MasonHuang04/450SourceOri/01_Elec/02_FrontEnd/制板说明.txt

4层板，层方案JLC0416H-3313, 绿油白字喷锡, 不需要过孔塞树脂。

PCB造10片，自己手贴2片。
