MasonHuang04/450SourceOri/01_Elec/01_MainBoard/A0/制板说明.txt

4层板，JLC叠层方案JLC0416H-3313A, 绿油白字喷锡, 过孔塞树脂。

PCB造10片，自己手贴2片。

元器件有好些之前有（电流钳，电流传感器，M之类），好好找找，有的就不要专门卖。FPGA相关的都是M的东西。应该不会有长周期物料。
