MasonHuang04/450SourceOri/verification/MATLAB/McuBudget_20261022/results/report.html

# 当前 FPGA 资源与 STM32G431 预算

2026-10-22。依据与当前SOF逐字节哈希匹配的Quartus报告，保留19 ms RX、1.145833 MS/s、CIC3 /32、672/1024 FFT及25–2000 Hz搜索。

判断：1024点FFT本身不是否定G431的理由。采用DMA分块、流式混频/CIC、结果为主的方案有实现可能；不能把现有256 KiB波形缓存原样搬进32 KiB SRAM。若保留全部波形、物理正弦参考DAC和更多缓冲，RAM很紧。采集实时性仍须用真实MCU代码测量，本文没有用MATLAB耗时冒充MCU耗时。

## 1. 实际 FPGA 资源

当前含TMP117温度补偿和M4距离报文：8507 ALM、17561寄存器、44 DSP、272 M10K，配置存储位数2201010 bits，约268.68 KiB。之前仅25–2000 Hz FFT版为7053 ALM、31 DSP，存储相同。

output_files中的详细fit.rpt仍是旧版，但fit.summary/build_checks与当前SOF一致。本次从验证资料引用的编译快照找到匹配当前SOF的完整fit.rpt，按其实体表统计；没有改写旧报告。

模块 | ALM（层级估算） | DSP块 | 配置存储 KiB | M10K
MainTxController | 3234.0 | 19 | 7.244 | 10
MainRxController | 910.4 | 3 | 0.000 | 0
MainFftProcessor | 1908.8 | 8 | 5.434 | 6
kaiser4_rfft | 763.3 | 5 | 3.434 | 4
fft_power_peak | 113.0 | 2 | 0.000 | 0
main_peak_interpolator | 537.5 | 1 | 0.000 | 0
MainRangeCalculator | 1440.9 | 13 | 0.000 | 0
MainWaveFifo | 275.0 | 0 | 256.000 | 256

FFT分支包括下属CIC、加窗FFT、功率和插值，父子行不能相加。原始波形缓存配置为131072×16位，即256 KiB，占全工程配置存储位数的95.28%。M10K块数还包含物理分块碎片，不能把块数直接当有效数据字节数。

44个FPGA DSP块不等于MCU需要44个处理器。FPGA硬件并行且有些模块只在每帧运行一次，MCU可复用乘法/FPU。TX部分目前在165 MHz DAC时钟流水计算浮点Chirp，不能直接逐拍移植到170 MHz CPU；方波版本应让定时器/PWM/DMA承担边沿输出。

## 2. 每帧算法工作量

19 ms约21770个原始样本/通道。原FPGA使用外部模拟混频，MCU数字混频方案新增一次RX×参考乘法/样本。下表是公式运算次数，不是CPU周期，未把搬运、寻址、缩放、饱和、循环、外设与中断开销算成免费。

阶段 | 乘法表达式/帧 | 加减/帧 | 说明
Digital RX x reference mixing (new) | 21770 | 0 | Rescaling/saturation/memory access excluded
CIC3 integrators | 0 | 65310 | 40-bit FPGA states: typically 64-bit MCU arithmetic
CIC3 combs | 0 | 2040 | One decimated output per 32 raw samples
Frame sum and DC removal | 0 | 1344 | One mean division per frame
Kaiser4 window | 672 | 0 | Precomputed coefficients, no runtime Bessel evaluation
1024 real FFT: 512 complex FFT + split | 10236 | 16376 | Expression counts, not optimized CMSIS instructions
Power at all 513 bins | 1026 | 513 | Only 59 bins are needed for equivalent peak/neighbour processing
Peak comparison in bins 1 to 57 | 0 | 0 | 57 eligible bins, approximately 56 max comparisons
Peak interpolation | 0 | 0 | 3 logarithms and 1 divide, or existing 48-squaring fixed algorithm

1024实数FFT按当前实现分解为512复数FFT的2304个蝶形，加上实数频谱重组。运算表达式约10236次实乘和16376次加减；CMSIS使用不同的优化内核，实际指令数不一定等于这个计数。三点插值每帧只有3次log和1次除法；温度与距离同样每帧计算一次，通常不是持续采集的主负载。

现有FPGA的数字FFT处理实测为23430个50 MHz周期，约0.4686 ms；插值140周期约2.8 us，新增距离计算最多168周期约3.36 us。FPGA并行资源与CPU指令不同，不能按170/50简单换算为MCU耗时。

## 3. 采集期间的硬预算

170 MHz / 1.145833 MS/s = 148.36 CPU周期/样本对，即每0.873 us来一对同步样本。采用512对样本的DMA半缓冲时，处理期限约446.84 us，共约75962周期。应按最坏执行时间验收，并留中断、PWM与通信余量；以不超过约74周期/样本对作为50%预算目标，而非已测性能。

假设完整流式处理成本 | 采集期间CPU占用 | 19 ms内CPU工作时间
32 | 21.6% | 4.098 ms
64 | 43.1% | 8.196 ms
96 | 64.7% | 12.294 ms
128 | 86.3% | 16.392 ms
160 | 107.8% | 20.489 ms

这些周期值是敏感性情景，不是G431测量。完整流式成本须包括RX乘参考、40位CIC所需的64位运算、定标、存取和循环。若数字参考也由CPU生成，需把相位更新/查表成本一起算入。应使用预计算表或经验证的相位递推，避免每个原始样本调用通用double sin/cos。

若坚持输出模拟正弦参考再双ADC采样，参考DAC生成也是额外工作。举例：ADC混频/CIC若需64周期/样本，另以1 MS/s、32周期/样本生成DAC参考，合计约62% CPU；如果ADC处理128周期且DAC生成40周期，则超过170 MHz预算。这仍是假设情景。片内外部DAC最高1 MS/s，不能复现原FPGA的165 MS/s DAC更新节拍。

## 4. FFT耗时的证据边界

ST AN4841的另一款Cortex-M4（STM32F429）1024点复数FFT基准给出Q15为82299周期、Q31为153307周期。仅假设相同周期数，在170 MHz分别约0.484 ms、0.902 ms。它们不是G431的实数float32 FFT实测。可先给FFT预留0.5–1.5 ms工程预算，最终用选定CMSIS版本、数据类型、编译选项和内存布局测量。

CMSIS的float32快速RFFT利用实数对称性，1024点输入与输出各1024个float，合计8 KiB。Q15/Q31的输出布局和容量可能不同，不应直接套用8 KiB估算。CMSIS输出缩放也必须与当前功率门限和插值对照验证。

## 5. 32 KiB SRAM怎样安排

分配项 | 字节 | KiB
RFFT input/work buffer | 4096 | 4.000
RFFT output buffer | 4096 | 4.000
Dual ADC DMA, 2 halves x 512 pairs | 4096 | 4.000
Filter state, telemetry and scratch reserve | 1024 | 1.000
Application/HAL/stack reserve | 4096 | 4.000
Optional runtime PWM ARR/CCR table | 3200 | 3.125
Optional current RX waveform buffer | 10884 | 10.629
Optional sine-reference DAC ping-pong buffer | 2048 | 2.000

结果为主的基础方案约17.000 KiB；加运行时PWM表约20.125 KiB。保留当前5442点波形后约30.754 KiB，余量仅1.246 KiB；再加模拟参考DAC双缓冲约32.754 KiB，已超过32 KiB。预先固定的PWM表若可放Flash，可以减少RAM，但运行时改TX参数的需求也要考虑。这里的1 KiB scratch与4 KiB应用/栈是设计预留，不是链接器实测。

整帧原始ADC一路需要42.52 KiB、两路需要85.04 KiB，均不能直接存入32 KiB。窗系数、旋转因子、相位表应优先放Flash，并只链接需要的FFT尺寸。若产品要保存两路完整原始波形，至少重新评估128 KiB级或更大RAM器件，而不是只比较CPU频率。

## 6. 其他必须保留在预算里的约束

当前完整原始波形+M4为11058字节，2 Mbaud/8N1线路时间约55.29 ms；只发110字节M4约0.55 ms。若还保持每帧完整波形回传，串口可能先于FFT成为刷新率限制。当前上位机连续模式还有约1秒等待，低平均CPU负载不能代替采集窗口内的实时性检查。

G431原生ADC为12位，当前模型是16位，性能不能仅凭采样率等同。ADC取样时间、DMA可达地址、准确采样率、双通道偏斜、参考相位同步、定时器周期量化和模拟前端都需另外验证。本预算保持现有CIC，没有计入将来可能增加的FIR/IIR抗混叠或声学补偿计算。

## 建议的MCU验收

1. 先用DMA分块实现采样、数字混频和CIC。测DWT_CYCCNT的最坏周期数及DMA溢出计数，保持ADC流无丢点。
2. 离线对比672点输出、1024点FFT及峰值插值，再测整帧计算时间，不能只测单独FFT。
3. 查看真实链接器RAM/Flash占用与栈高水位，同时运行PWM、ADC、温度和UART。决定是否保留整帧波形。

来源：ST G431数据手册 (https://www.st.com/resource/en/datasheet/stm32g431rb.pdf)；ST AN4841 (https://www.st.com/content/ccc/resource/technical/document/application_note/group0/c1/ee/18/7a/f9/45/45/3b/DM00273990/files/DM00273990.pdf/jcr:content/transla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)；Arm CMSIS-DSP RFFT文档 (https://arm-software.github.io/CMSIS-DSP/main/group__RealFFT.html)。FPGA数据的SOF哈希与来源路径见fpga_resources.json。

运算量CSV · CPU预算CSV · RAM预算CSV · FPGA模块占用 · 预算参数
