MasonHuang04/450SourceOri/verification/FFT/full_top/spectrum.csv

case | bin | real | imag | power
0 | 0 | -9 | 0 | 81
0 | 1 | 11 | 2 | 125
0 | 2 | 6 | 3 | 45
0 | 3 | 5 | 5 | 50
0 | 4 | 5 | 7 | 74
0 | 5 | 5 | 9 | 106
0 | 6 | 5 | 11 | 146
0 | 7 | 5 | 13 | 194
0 | 8 | 5 | 16 | 281
0 | 9 | 5 | 19 | 386
0 | 10 | 6 | 22 | 520
0 | 11 | 6 | 27 | 765
0 | 12 | 6 | 32 | 1060
0 | 13 | 6 | 38 | 1480
0 | 14 | 7 | 46 | 2165
0 | 15 | 7 | 56 | 3185
0 | 16 | 9 | 71 | 5122
0 | 17 | 10 | 91 | 8381
0 | 18 | 12 | 123 | 15273
0 | 19 | 16 | 178 | 31940
0 | 20 | 23 | 286 | 82325
0 | 21 | 39 | 520 | 271921
0 | 22 | 530 | 7694 | 59478536
0 | 23 | -1111 | -16623 | 277558450
0 | 24 | 279 | 4226 | 17936917
0 | 25 | 26 | 370 | 137576
0 | 26 | 10 | 118 | 14024
0 | 27 | 5 | 43 | 1874
0 | 28 | 3 | 13 | 178
0 | 29 | 2 | -2 | 8
0 | 30 | 2 | -9 | 85
0 | 31 | 2 | -13 | 173
0 | 32 | 2 | -15 | 229
0 | 33 | 1 | -16 | 257
0 | 34 | 1 | -17 | 290
0 | 35 | 1 | -17 | 290
0 | 36 | 1 | -17 | 290
0 | 37 | 2 | -17 | 293
0 | 38 | 1 | -17 | 290
0 | 39 | 2 | -16 | 260
0 | 40 | 1 | -16 | 257
0 | 41 | 1 | -16 | 257
0 | 42 | 2 | -15 | 229
0 | 43 | 1 | -15 | 226
0 | 44 | 1 | -14 | 197
0 | 45 | 1 | -15 | 226
0 | 46 | 1 | -14 | 197
0 | 47 | 1 | -14 | 197
0 | 48 | 2 | -13 | 173
0 | 49 | 2 | -13 | 173
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
