MasonHuang04/450SourceOri/verification/FFT/Main_20261017/spectrum_100hz.csv

bin | frequency_hz | real_q3 | imag_q3 | power_q6
0 | 0 | 6 | 0 | 36
1 | 4.37100728353 | 1 | 1 | 2
2 | 8.74201456706 | 2 | 3 | 13
3 | 13.1130218506 | 2 | 5 | 29
4 | 17.4840291341 | 2 | 7 | 53
5 | 21.8550364176 | 1 | 9 | 82
6 | 26.2260437012 | 1 | 11 | 122
7 | 30.5970509847 | 2 | 13 | 173
8 | 34.9680582682 | 2 | 16 | 260
9 | 39.3390655518 | 2 | 19 | 365
10 | 43.7100728353 | 1 | 23 | 530
11 | 48.0810801188 | 1 | 27 | 730
12 | 52.4520874023 | 1 | 32 | 1025
13 | 56.8230946859 | 2 | 38 | 1448
14 | 61.1941019694 | 1 | 46 | 2117
15 | 65.5651092529 | 1 | 56 | 3137
16 | 69.9361165365 | 1 | 71 | 5042
17 | 74.30712382 | 0 | 91 | 8281
18 | 78.6781311035 | 0 | 124 | 15376
19 | 83.049138387 | -1 | 179 | 32042
20 | 87.4201456706 | -2 | 287 | 82373
21 | 91.7911529541 | -6 | 523 | 273565
22 | 96.1621602376 | -99 | 7714 | 59515597
23 | 100.533167521 | 226 | -16674 | 278073352
24 | 104.904174805 | -57 | 4234 | 17930005
25 | 109.275182088 | -4 | 370 | 136916
26 | 113.646189372 | 0 | 118 | 13924
27 | 118.017196655 | 1 | 43 | 1850
28 | 122.388203939 | 1 | 13 | 170
29 | 126.759211222 | 2 | -2 | 8
30 | 131.130218506 | 1 | -9 | 82
31 | 135.501225789 | 2 | -13 | 173
32 | 139.872233073 | 2 | -15 | 229
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
