MasonHuang04/450SourceOri/verification/FFT/Interpolation_20261020/report.html

# Main：FPGA 内的三点峰值插值

2026-10-20 · 本地实现与验证 · 新 Main SOF + M2 上位机

采样 → CIC /32 → Kaiser4 → 8192 点 FFT → 最大功率频点 → 三点对数插值（新增） → UART

插值发生在 FFT 之后，利用峰值及左右邻点估计峰顶位置。log、除法和偏移均在 FPGA 完成；电脑只解析 Q16 结果并换算 Hz。Chirp、RX 250 ms、采样率、8192点和两个独立实验保持原样。

验证通过：完整 Main 数字处理分支、1136组插值检查、71614点原始数据/M2回传、短ADC与真实2 Mbaud UART、生产C#解析。Quartus全编译通过；84项时序检查无负余量，最小 +0.008 ns，无未约束的Setup/Hold路径。

## 完整 Main RTL 的前后对比

输入 Hz | 原频点 Hz | 插值 Hz | 原误差 Hz | 插值误差 Hz
25 | 26.226044 | 24.861304 | +1.226044 | -0.138696
100 | 100.533168 | 99.921029 | +0.533168 | -0.078971
500 | 498.294830 | 500.113038 | -1.705170 | +0.113038
250 | 249.147415 | 250.115245 | -0.852585 | +0.115245
99.6 | 100.533168 | 99.477566 | +0.933168 | -0.122434

250 Hz案例叠加700 Hz干扰；99.6 Hz案例叠加抽取后的混叠频率附近干扰。异常削顶、短帧、空帧都不会被当作有效插值。功率仍报告原最大频点的功率。

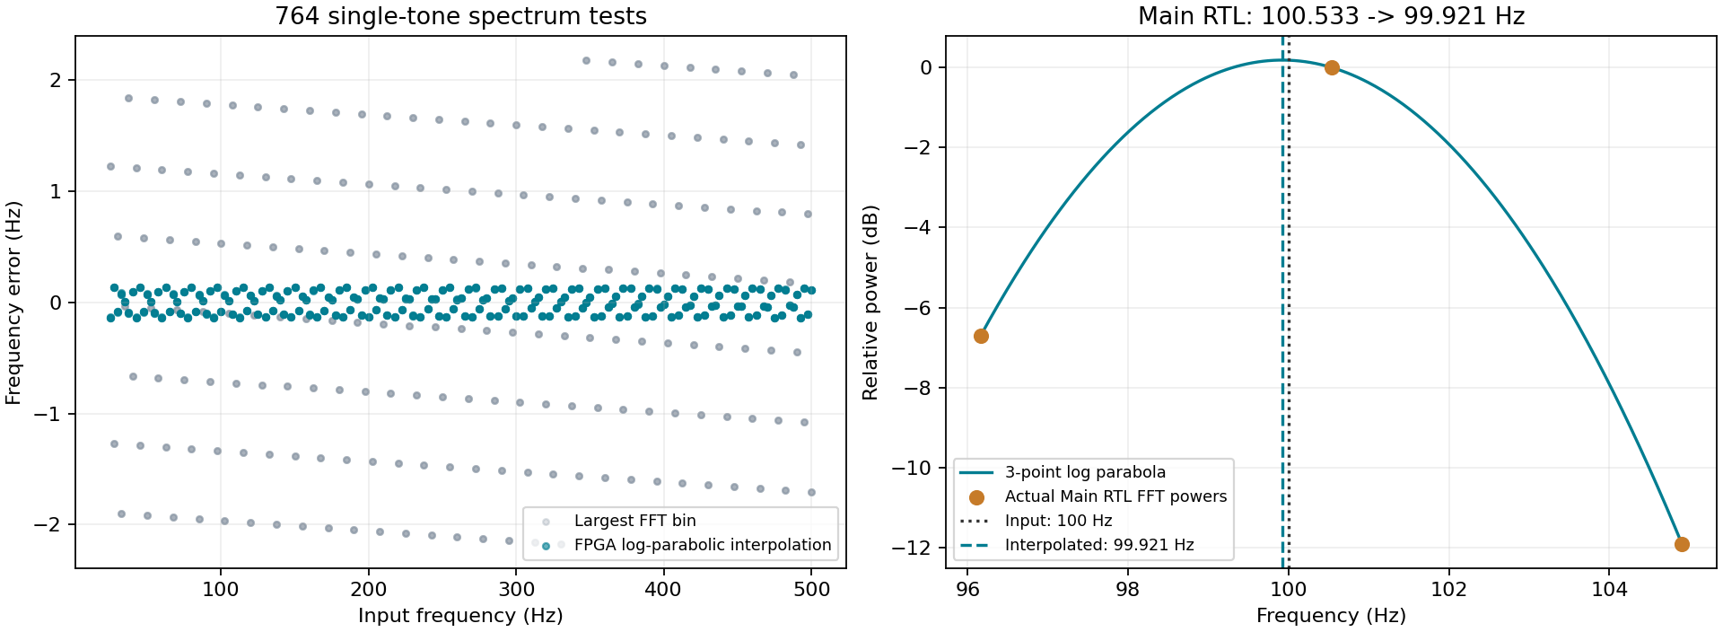
[picture p12: verification/FFT/Interpolation_20261020/comparison.png]


左图：NumPy生成量化频谱，实际RTL完成插值（191频率×4相位）；右图：完整Main RTL产生的100 Hz频谱。左图最大绝对误差从2.1806 Hz降至0.1404 Hz；另60组25 dB单音输入最大插值误差约0.1479 Hz。测试条件不同于论文图中的毫米测距指标。

## 运算量与资源

频率格仍为4.371007 Hz。新增插值最大140个50 MHz周期，约2.8 μs；不是减少现有FFT运算。资源为7190 ALM（13%）、31 DSP（20%）、307 RAM块（45%）；相比旧Main多584 ALM、874寄存器和1 DSP，块RAM用量不变。

## 使用方法

1. 在Programmer重新下载 Main 的 UsMimoTestBench.sof。
2. 运行 03_SW/RunMain.cmd，选主板COM口。
3. 外部发生器向RX输入连续100 Hz正弦，使用此前已验证的幅度与接线；点击“应用并采集一次”。
4. 比较界面的“FPGA插值”“原频点”和误差；参考频率只用于评价，不参与估计。

新软件兼容旧M1；旧固件会标明“未提供插值”。新固件使用76字节M2，需配套新版查看器。尚未进行这版固件的实板验证。

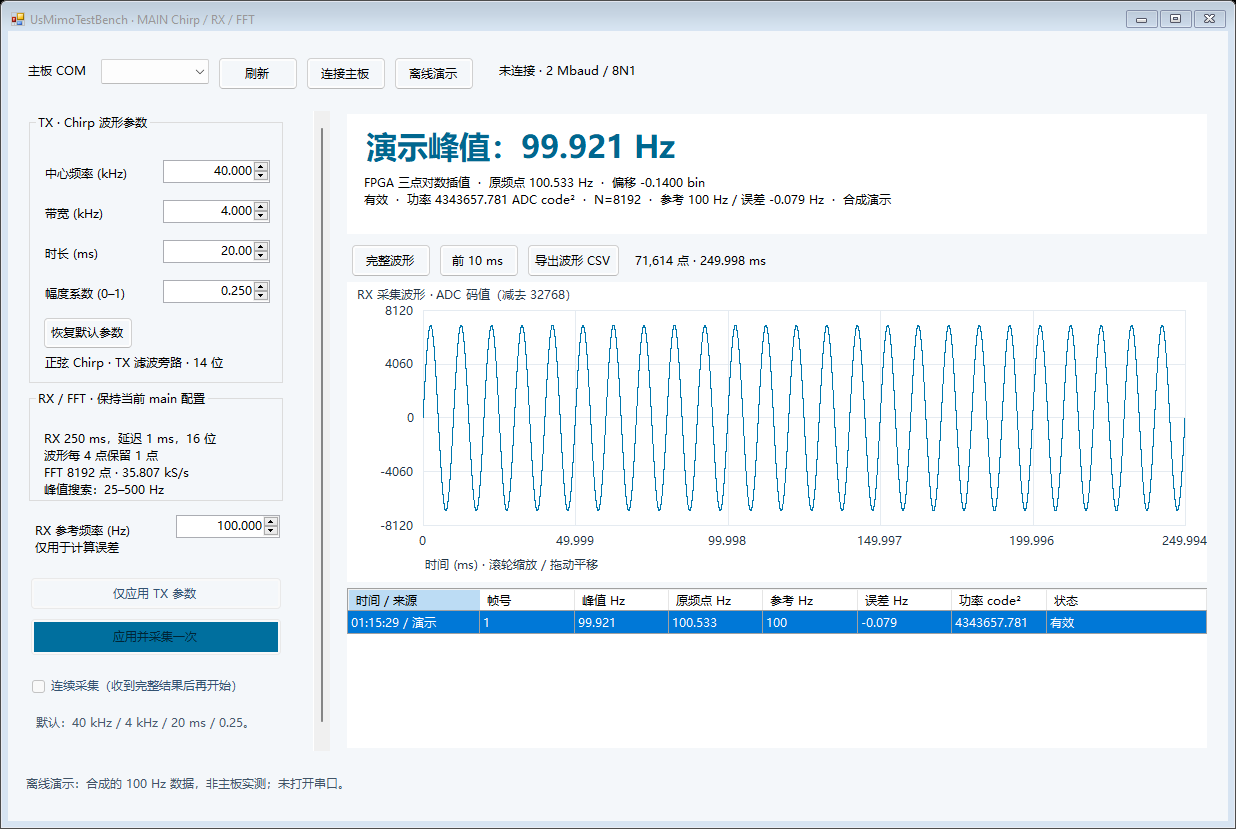
[picture p13: verification/FFT/Interpolation_20261020/ui.png]


界面截图为离线合成演示，不是实板测量。

## 可复现入口

在Simulation/FFT中运行 python run_main.py --interp、--fast-memory、--system、--short 或 --io。沿用原来的两个FFT测试台文件。

检查数据 · 对比CSV · 源码/日志证据 · 算法、协议与使用说明

插值提升孤立峰的位置估计，不改变采集时长或物理分辨能力；不能保证噪声、多目标、非稳态或实板条件下都达到上述误差。没有新增FPGA混频或距离换算。
