MasonHuang04/450SourceOri/(list of files, cad)

Other CAD files:
02_RTL/V0/AD.stp
