MasonHuang04/450SourceOri/verification/Figures/README.md

# 汇报素材

- [早期200kHz TX扫频图](200k_summary/01_TX_sweep.png)
- [早期RX对齐示意图](200k_summary/02_RX_aligned.png)
- [FFT参考输入图](fft_reference_input/FFT_Input_725p587Hz.png)
- [FFT参考输入原始数据](fft_reference_input/FFT_Input_725p587Hz.csv)

这些是此前汇报的素材，保留原有含义，不代表当前40kHz发射/50–100Hz FFT配置。当前示例图见Simulation的两个results目录。draw.io中原始数据链接已随目录调整。
