MasonHuang04/450SourceOri/verification/FFT/full_top/metadata.csv

case | count | span | flags | bin | power | dc_mean
0 | 2048 | 6288384 | 0 | 23 | 277558450 | 114
