MasonHuang04/450SourceOri/verification/AcousticAudit_20261020/data/rtl_metadata.csv

case | seq | count | span | flags | bin | power | mean | delta_q16 | interp_status | process_cycles
0 | 1 | 672 | 21472 | 0 | 2 | 112232500 | -4820 | -24901 | 0 | 23430
1 | 2 | 672 | 21472 | 0 | 2 | 104559496 | 6826 | 30416 | 0 | 23430
2 | 3 | 672 | 21472 | 0 | 4 | 121257009 | -4961 | 12053 | 0 | 23430
3 | 4 | 672 | 21472 | 0 | 3 | 123445274 | 299 | -9562 | 0 | 23430
4 | 5 | 672 | 21472 | 0 | 11 | 121297114 | 304 | -9120 | 0 | 23430
5 | 6 | 672 | 21472 | 36 | 2 | 2995915525 | 7673 | 0 | 1 | 23291
6 | 7 | 337 | 10752 | 1 | 0 | 0 | 7673 | 0 | 1 | 2
7 | 8 | 0 | 0 | 1 | 0 | 0 | 7673 | 0 | 1 | 2
