MasonHuang04/450SourceOri/verification/Chirp/README.md

# Chirp 验证记录

这里保留实验1初次上板准备时的控制和真实Intel数值核验证记录，2001个检查点对应原来的10us索引间隔；未把它重新命名为最新仿真。

- [控制/数值检查](tests/checks.json)
- [原基线编译检查](build_checks.json)
- [当时的数字输出](tests/quarter_amplitude.csv)
- [当前仿真入口](../../02_RTL/V0/Simulation/Chirp/run.py)
- [整理后生成的波形图](../../02_RTL/V0/Simulation/Chirp/results/chirp.png)
- [当前编译检查记录](../../02_RTL/V0/output_chirp_scope_40k20ms/build_checks.json)

重复的ROM展开文件、临时配置和重复Transcript已纳入历史压缩包。现场示波器照片在 Measurements。
