MasonHuang04/450SourceOri/verification/Measurements/README.md

# 实板记录

- [示波器照片](evidence/experiment1_scope_41p95khz.jpg)
- [串口日志索引与校验值](evidence/serial_log_index.json)
- [新版FFT实板日志快照](evidence/RxFftLowFreqMonitor/FFT_20261016_210312.csv)

原始记录按字节保留。部分记录的查看器目标频率未随发生器变化更新，不能把全文件的error_hz直接当成逐频点误差验收；详细解释见工程根目录readme_2026-10-16.md。
