MasonHuang04/450SourceOri/verification/SW/README.md

# 上位机验证索引

- [界面与验证报告](MainUI_20261017/report.html)
- [使用说明](../../03_SW/README_main_2026-10-17.md)
- [软件检查](MainUI_20261017/checks.txt)
- [真实UART RTL协议验证日志](MainUI_20261017/settings_uart.log)
- [版本和源码哈希](MainUI_20261017/manifest.json)
- [完整软件验证证据包](MainUI_20261017/evidence.zip)

截图是明确标识的离线合成演示，不是实板测量。已验证完整历史RTL数据解析和设置包通过UART/RxDepack；真实COM联调尚未进行。

默认/自定义命令hex、导出示例CSV、两份构建日志已保存于evidence.zip，删除了它们的重复展开副本。`ui_normal.png`、`ui_compact.png`、`ui_detail.png` 是三种不同视图，均保留；相同内容的 `ui_preview.png` 已去重。
