MasonHuang04/450SourceOri/verification/On_device_original/original_distance_add_temp.xls

 | temp:25.3 - 25.32
real:cm
 |  |  | real distance
 |  |  | 10 | 171.862
 |  |  | 12.5 | 300.795 |  |  |  |  | 10 | 171.862
 |  |  | 15 | 366.32 |  |  |  |  | 17.5 | 245.312
 |  |  | 17.5 | 245.312 |  |  |  |  | 20 | 268.46
 |  |  | 20 | 268.46 |  |  |  |  | 22.5 | 292.558
 |  |  | 22.5 | 292.558 |  |  |  |  | 25 | 317.109
 |  |  | 25 | 317.109 |  |  |  |  | 27.5 | 340.549
 |  |  | 27.5 | 340.549 |  |  |  |  | 30 | 368.341
 |  |  | 30 | 368.341 |  |  |  |  | 32.5 | 392.001
 |  |  | 32.5 | 392.001 |  |  |  |  | 35 | 416.42
 |  |  | 35 | 416.42 |  |  |  |  | 37.5 | 439.76
 |  |  | 37.5 | 439.76 |  |  |  |  | 40 | 465.443
 |  |  | 40 | 465.443 |  |  |  |  | 42.5 | 479.952
 |  |  | 42.5 | 479.952 |  |  |  |  | 45 | 515.935
 |  |  | 45 | 515.935 |  |  |  |  | 47.5 | 539.267
 |  |  | 47.5 | 539.267 |  |  |  |  | 50 | 567.111
 |  |  | 50 | 567.111
 |  |  |  | 10
 |  |  |  | 12.5
 |  |  |  | 15 | 10 | 172.159
 |  |  |  | 17.5 | 12.5 | 302.729 | 10 | 172.159
 |  |  |  | 20 | 15 | x | 12.5 | 302.729 |  |  | 10 | 172.159
 |  |  |  | 22.5 | 17.5 | 249.364 | 17.5 | 249.364 |  |  | 17.5 | 249.364
 |  |  |  | 25 | 20 | 270.955 | 20 | 270.955 |  |  | 20 | 270.955
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
