MasonHuang04/450SourceOri/verification/AcousticAudit_20261020/envelope_model.csv

receive_time_s | uncompensated_envelope | shaped_envelope | uncompensated_if | shaped_if
1.000000000000000021e-03 | 2.582370107877094423e-01 | 2.381925090326269812e-01 | 6.510913876842941428e-02 | 6.005533086407534998e-02
1.027927272727272717e-03 | 2.591183717762796657e-01 | 2.381024821405756664e-01 | 5.889681107804769361e-02 | 5.411996382856035237e-02
1.055854545454545414e-03 | 2.600104800254252058e-01 | 2.380127595165975329e-01 | 5.260422061088666085e-02 | 4.815373483635233126e-02
1.083781818181818110e-03 | 2.609134200920220081e-01 | 2.379233569706740714e-01 | 4.623444327808278603e-02 | 4.216055252547750570e-02
1.111709090909091023e-03 | 2.618272763934076375e-01 | 2.378342902762946576e-01 | 3.979061924883102452e-02 | 3.614433843203004176e-02
1.139636363636363720e-03 | 2.627521331905957602e-01 | 2.377455751639536430e-01 | 3.327595221412719961e-02 | 3.010902443382735758e-02
1.167563636363636416e-03 | 2.636880745712621987e-01 | 2.376572273146788095e-01 | 2.669370862180568335e-02 | 2.405855019465360720e-02
1.195490909090909113e-03 | 2.646351844325239289e-01 | 2.375692623536117265e-01 | 2.004721688213609299e-02 | 1.799686061074883686e-02
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
