MasonHuang04/450SourceOri/verification/AcousticAudit_20261020/ideal_beats.csv

distance_cm | ideal_beat_hz | observed_cycles | synthetic_rtl_hz | error_hz
5 | 58.309037900874635 | 1.0942931354359926 | 56.649684362734355 | -1.6593535381402802
7.5 | 87.46355685131195 | 1.641439703153989 | 86.16518850127855 | -1.2983683500333996
12.5 | 145.7725947521866 | 2.7357328385899815 | 146.3033549953252 | 0.5307602431386158
