MasonHuang04/450SourceOri/verification/AcousticAudit_20261020/measured_jumps.csv

before_time | before_sequence | before_status | before_peak_hz | before_bin | before_raw_bin_hz | before_delta_q16 | after_time | after_sequence | after_status | after_peak_hz | after_bin | after_raw_bin_hz | after_delta_q16
2026-10-20T17:05:58.4304999+08:00 | 50 | OK | 196.25353161245585 | 6 | 209.808349609375 | -25404 | 2026-10-20T17:05:59.6880795+08:00 | 51 | OK | 404.99847576332587 | 12 | 419.61669921875 | -27397
2026-10-20T17:07:00.0191155+08:00 | 98 | OK | 411.35436428400374 | 12 | 419.61669921875 | -15485 | 2026-10-20T17:07:01.5302720+08:00 | 99 | OK | 213.67246517911551 | 6 | 209.808349609375 | 7242
2026-10-20T17:07:21.8072617+08:00 | 115 | OK | 143.1312800074617 | 4 | 139.87223307291666 | 6108 | 2026-10-20T17:07:23.2301534+08:00 | 116 | OK | 307.644319642956 | 9 | 314.7125244140625 | -13247
2026-10-20T17:08:29.3159464+08:00 | 167 | OK | 503.91119051103789 | 14 | 489.55281575520831 | 26910 | 2026-10-20T17:08:30.5586956+08:00 | 168 | OK | 279.72045548570651 | 8 | 279.74446614583331 | -45
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
