MasonHuang04/450SourceOri/verification/FFT/DistanceSweep_20261021/distance_results.csv

case | distance_cm | delay_s | ideal_beat_hz | nominal_search_contains_beat | raw_bin | raw_bin_hz | interpolated_hz | delta_q16 | interp_status | flags | power_code_squared | estimated_distance_cm | signed_error_mm | raw_bin_error_mm | available_echo_ms
0 | 10.0 | 0.0005830903790087463 | 116.61807580174927 | True | 3 | 104.9041748046875 | 116.71955386797586 | 22144 | 0 | 0 | 1759685.78125 | 10.00870174417893 | 0.08701744178930326 | -10.044670104980469 | 18.767127272727272
1 | 12.5 | 0.0007288629737609329 | 145.7725947521866 | True | 4 | 139.87223307291666 | 146.13101181263724 | 11730 | 0 | 0 | 1880690.78125 | 12.530734262933644 | 0.30734262933643564 | -5.059560139973964 | 18.767127272727272
2 | 15.0 | 0.0008746355685131195 | 174.9271137026239 | True | 5 | 174.84029134114581 | 174.9128568917513 | 136 | 0 | 0 | 1942087.78125 | 14.998777478467673 | -0.012225215323269367 | -0.07445017496745976 | 18.767127272727272
3 | 17.5 | 0.001020408163265306 | 204.0816326530612 | True | 6 | 209.808349609375 | 203.78434176867205 | -11290 | 0 | 0 | 1892739.3125 | 17.47450730666363 | -0.25492693336371275 | 4.9106597900390625 | 18.74671910946197
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
