MasonHuang04/450SourceOri/verification/FFT/Search2k_20261021/comparison.csv

distance_cm | previous_hz | current_hz | previous_error_mm | current_error_mm
10.0 | 116.71955386797586 | 116.71955386797586 | 0.08701744178930326 | 0.08701744178930326
12.5 | 146.13101181263724 | 146.13101181263724 | 0.30734262933643564 | 0.30734262933643564
15.0 | 174.9128568917513 | 174.9128568917513 | -0.012225215323269367 | -0.012225215323269367
17.5 | 203.78434176867205 | 203.78434176867205 | -0.25492693336371275 | -0.25492693336371275
20.0 | 232.86712045470873 | 232.86712045470873 | -0.3164442100872833 | -0.3164442100872833
22.5 | 262.5474977927903 | 262.5474977927903 | 0.13447935731768723 | 0.13447935731768723
25.0 | 291.9920370914042 | 291.9920370914042 | 0.38317180587910116 | 0.38317180587910116
27.5 | 320.9590310386071 | 320.9590310386071 | 0.22236911560561623 | 0.22236911560561623
30.0 | 349.7595510755976 | 349.7595510755976 | -0.08118495267506631 | -0.08118495267506631
32.5 | 378.74308569977677 | 378.74308569977677 | -0.22780401244141046 | -0.22780401244141046
35.0 | 407.9235077369958 | 407.9235077369958 | -0.20559211552608758 | -0.20559211552608758
37.5 | 437.3130893024305 | 437.3130893024305 | -0.004025923165826839 | -0.004025923165826839
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
