MasonHuang04/450SourceOri/verification/FFT/TemperatureRange_20261021/range_results.csv

id | fm | dist | status | cycles
0 | 58300 | 46520 | 0 | 168
1 | 58300 | 93041 | 0 | 168
2 | 58300 | 23 | 0 | 168
3 | 58300 | 232602 | 0 | 168
4 | 58300 | 23260 | 0 | 168
5 | 58300 | 46520 | 0 | 168
6 | 58300 | 12 | 0 | 168
7 | 58300 | 116301 | 0 | 168
8 | 58300 | 1485684 | 0 | 168
9 | 58300 | 2971368 | 0 | 168
10 | 58300 | 743 | 0 | 168
11 | 58300 | 7428421 | 0 | 168
12 | 100000 | 79795 | 0 | 168
13 | 100000 | 159590 | 0 | 168
14 | 100000 | 40 | 0 | 168
15 | 100000 | 398975 | 0 | 168
16 | 100000 | 39898 | 0 | 168
17 | 100000 | 79795 | 0 | 168
18 | 100000 | 20 | 0 | 168
19 | 100000 | 199488 | 0 | 168
20 | 100000 | 2548343 | 0 | 168
21 | 100000 | 5096687 | 0 | 168
22 | 100000 | 1274 | 0 | 168
23 | 100000 | 12741717 | 0 | 168
24 | 145800 | 116341 | 0 | 168
25 | 145800 | 232682 | 0 | 168
26 | 145800 | 58 | 0 | 168
27 | 145800 | 581706 | 0 | 168
28 | 145800 | 58171 | 0 | 168
29 | 145800 | 116341 | 0 | 168
30 | 145800 | 29 | 0 | 168
31 | 145800 | 290853 | 0 | 168
32 | 145800 | 3715485 | 0 | 168
33 | 145800 | 7430969 | 0 | 168
34 | 145800 | 1858 | 0 | 168
35 | 145800 | 18577423 | 0 | 168
36 | 380000 | 303221 | 0 | 168
37 | 380000 | 606442 | 0 | 168
38 | 380000 | 152 | 0 | 168
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
