MasonHuang04/450SourceOri/verification/FFT/Interpolation_20261020/main_comparison.csv

input_hz | peak_hz | error_hz | interpolated_hz | interpolated_error_hz | delta_q16
25 | 26.226043701171875 | 1.226043701171875 | 24.861304458075512 | -0.13869554192448774 | -20462
100 | 100.53316752115884 | 0.5331675211588447 | 99.92102908048157 | -0.07897091951842583 | -9178
500 | 498.29483032226557 | -1.7051696777344318 | 500.1130375603679 | 0.11303756036789991 | 27261
250 | 249.14741516113278 | -0.8525848388672159 | 250.11524485307743 | 0.11524485307742793 | 14511
99.6 | 100.53316752115884 | 0.9331675211588504 | 99.47756552719511 | -0.1224344728048834 | -15827
