MasonHuang04/450SourceOri/verification/FFT/Short20ms_20261020/comparison.csv

input_hz | long_hz | short_hz | short_error_hz
25 | 24.861304458075512 | 40.05351608308653 | 15.053516083086528
100 | 99.92102908048157 | 99.80964629600444 | -0.19035370399555518
500 | 500.1130375603679 | 500.2797115594148 | 0.27971155941480674
250 | 250.11524485307743 | 250.33460891184706 | 0.3346089118470559
99.6 | 99.47756552719511 | 98.77772148077686 | -0.8222785192231328
