MasonHuang04/450SourceOri/verification/FFT/full_top/capture.csv

case | index | code
0 | 0 | 2285
0 | 1 | 2746
0 | 2 | 3194
0 | 3 | 3627
0 | 4 | 4043
0 | 5 | 4439
0 | 6 | 4813
0 | 7 | 5165
0 | 8 | 5492
0 | 9 | 5792
0 | 10 | 6064
0 | 11 | 6307
0 | 12 | 6520
0 | 13 | 6701
0 | 14 | 6849
0 | 15 | 6964
0 | 16 | 7046
0 | 17 | 7093
0 | 18 | 7106
0 | 19 | 7084
0 | 20 | 7029
0 | 21 | 6939
0 | 22 | 6815
0 | 23 | 6659
0 | 24 | 6470
0 | 25 | 6250
0 | 26 | 5999
0 | 27 | 5720
0 | 28 | 5413
0 | 29 | 5080
0 | 30 | 4722
0 | 31 | 4342
0 | 32 | 3941
0 | 33 | 3521
0 | 34 | 3084
0 | 35 | 2633
0 | 36 | 2169
0 | 37 | 1695
0 | 38 | 1213
0 | 39 | 726
0 | 40 | 236
0 | 41 | -254
0 | 42 | -743
0 | 43 | -1228
0 | 44 | -1706
0 | 45 | -2175
0 | 46 | -2633
0 | 47 | -3078
0 | 48 | -3507
0 | 49 | -3918
0 | 50 | -4309
0 | 51 | -4678
0 | 52 | -5024
0 | 53 | -5345
0 | 54 | -5638
0 | 55 | -5904
0 | 56 | -6139
0 | 57 | -6344
0 | 58 | -6517
0 | 59 | -6658
0 | 60 | -6765
0 | 61 | -6838
0 | 62 | -6877
0 | 63 | -6882
0 | 64 | -6852
0 | 65 | -6788
0 | 66 | -6690
0 | 67 | -6558
0 | 68 | -6394
0 | 69 | -6198
0 | 70 | -5970
0 | 71 | -5713
0 | 72 | -5426
0 | 73 | -5113
0 | 74 | -4774
0 | 75 | -4411
0 | 76 | -4025
0 | 77 | -3619
0 | 78 | -3195
0 | 79 | -2755
0 | 80 | -2300
0 | 81 | -1834
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
