MasonHuang04/450SourceOri/verification/FFT/Main_20261017/system_raw_words.csv

index | code
0 | 32890
1 | 32905
2 | 32921
3 | 32936
4 | 32951
5 | 32967
6 | 32982
7 | 32997
8 | 33013
9 | 33028
10 | 33044
11 | 33059
12 | 33074
13 | 33090
14 | 33105
15 | 33120
16 | 33136
17 | 33151
18 | 33166
19 | 33182
20 | 33197
21 | 33212
22 | 33228
23 | 33243
24 | 33258
25 | 33274
26 | 33289
27 | 33304
28 | 33320
29 | 33335
30 | 33350
31 | 33366
32 | 33381
33 | 33396
34 | 33412
35 | 33427
36 | 33442
37 | 33457
38 | 33473
39 | 33488
40 | 33503
41 | 33519
42 | 33534
43 | 33549
44 | 33564
45 | 33580
46 | 33595
47 | 33610
48 | 33626
49 | 33641
50 | 33656
51 | 33671
52 | 33687
53 | 33702
54 | 33717
55 | 33732
56 | 33748
57 | 33763
58 | 33778
59 | 33793
60 | 33808
61 | 33824
62 | 33839
63 | 33854
64 | 33869
65 | 33885
66 | 33900
67 | 33915
68 | 33930
69 | 33945
70 | 33960
71 | 33976
72 | 33991
73 | 34006
74 | 34021
75 | 34036
76 | 34051
77 | 34066
78 | 34082
79 | 34097
80 | 34112
81 | 34127
82 | 34142
83 | 34157
84 | 34172
85 | 34187
86 | 34202
87 | 34217
88 | 34233
89 | 34248
90 | 34263
91 | 34278
92 | 34293
93 | 34308
94 | 34323
95 | 34338
96 | 34353
97 | 34368
98 | 34383
99 | 34398
100 | 34413
101 | 34428
102 | 34443
103 | 34458
104 | 34473
105 | 34488
106 | 34503
107 | 34518
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
