MasonHuang04/450SourceOri/verification/FFT/Main_20261017/waveform_100hz.csv

index | time_s | filtered_adc_code
0 | 0 | 8703
1 | 2.79272727273e-05 | 8816
2 | 5.58545454545e-05 | 8928
3 | 8.37818181818e-05 | 9039
4 | 0.000111709090909 | 9149
5 | 0.000139636363636 | 9259
6 | 0.000167563636364 | 9367
7 | 0.000195490909091 | 9474
8 | 0.000223418181818 | 9580
9 | 0.000251345454545 | 9685
10 | 0.000279272727273 | 9789
11 | 0.0003072 | 9892
12 | 0.000335127272727 | 9993
13 | 0.000363054545455 | 10093
14 | 0.000390981818182 | 10192
15 | 0.000418909090909 | 10290
16 | 0.000446836363636 | 10386
17 | 0.000474763636364 | 10481
18 | 0.000502690909091 | 10575
19 | 0.000530618181818 | 10667
20 | 0.000558545454545 | 10758
21 | 0.000586472727273 | 10847
22 | 0.0006144 | 10935
23 | 0.000642327272727 | 11022
24 | 0.000670254545455 | 11106
25 | 0.000698181818182 | 11190
26 | 0.000726109090909 | 11271
27 | 0.000754036363636 | 11351
28 | 0.000781963636364 | 11430
29 | 0.000809890909091 | 11506
30 | 0.000837818181818 | 11581
31 | 0.000865745454545 | 11655
32 | 0.000893672727273 | 11726
33 | 0.0009216 | 11796
34 | 0.000949527272727 | 11864
35 | 0.000977454545455 | 11930
36 | 0.00100538181818 | 11994
37 | 0.00103330909091 | 12057
38 | 0.00106123636364 | 12117
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
