MasonHuang04/450SourceOri/verification/Figures/fft_reference_input/FFT_Input_725p587Hz.csv

sample_index | time_s | sample_signed16
0 | 0.000000000000 | 11428
1 | 0.000000872727 | 11413
2 | 0.000001745455 | 11399
3 | 0.000002618182 | 11383
4 | 0.000003490909 | 11368
5 | 0.000004363636 | 11353
6 | 0.000005236364 | 11337
7 | 0.000006109091 | 11322
8 | 0.000006981818 | 11306
9 | 0.000007854545 | 11290
10 | 0.000008727273 | 11273
11 | 0.000009600000 | 11257
12 | 0.000010472727 | 11240
13 | 0.000011345455 | 11223
14 | 0.000012218182 | 11206
15 | 0.000013090909 | 11189
16 | 0.000013963636 | 11172
17 | 0.000014836364 | 11154
18 | 0.000015709091 | 11137
19 | 0.000016581818 | 11119
20 | 0.000017454545 | 11101
21 | 0.000018327273 | 11083
22 | 0.000019200000 | 11064
23 | 0.000020072727 | 11046
24 | 0.000020945455 | 11027
25 | 0.000021818182 | 11008
26 | 0.000022690909 | 10989
27 | 0.000023563636 | 10970
28 | 0.000024436364 | 10950
29 | 0.000025309091 | 10931
30 | 0.000026181818 | 10911
31 | 0.000027054545 | 10891
32 | 0.000027927273 | 10871
33 | 0.000028800000 | 10850
34 | 0.000029672727 | 10830
35 | 0.000030545455 | 10809
36 | 0.000031418182 | 10788
37 | 0.000032290909 | 10767
38 | 0.000033163636 | 10746
39 | 0.000034036364 | 10725
40 | 0.000034909091 | 10703
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
