MasonHuang04/450SourceOri/verification/Measurements/evidence/RxFftLowFreqMonitor/FFT_20261016_210312.csv

time | sequence | status | count | bin | frequency_hz | target_hz | error_hz | power_code_squared | adc_min | adc_max | span_ticks | flags
2026-10-16T21:03:12.3225335+08:00 | 40 | OK | 2048 | 23 | 100.53316752 | 100.000 | 0.53316752 | 23070069.406250 | -16179 | 16100 | 6288384 | 0
2026-10-16T21:03:12.7946214+08:00 | 41 | OK | 2048 | 23 | 100.53316752 | 100.000 | 0.53316752 | 23067832.203125 | -16178 | 16099 | 6288384 | 0
2026-10-16T21:03:13.2746510+08:00 | 42 | OK | 2048 | 23 | 100.53316752 | 100.000 | 0.53316752 | 23064284.078125 | -16179 | 16100 | 6288384 | 0
2026-10-16T21:03:13.7537367+08:00 | 43 | OK | 2048 | 23 | 100.53316752 | 100.000 | 0.53316752 | 23061549.390625 | -16179 | 16099 | 6288384 | 0
2026-10-16T21:03:14.2339036+08:00 | 44 | OK | 2048 | 23 | 100.53316752 | 100.000 | 0.53316752 | 23058966.812500 | -16179 | 16100 | 6288384 | 0
2026-10-16T21:03:14.7139999+08:00 | 45 | OK | 2048 | 23 | 100.53316752 | 100.000 | 0.53316752 | 23056535.812500 | -16179 | 16099 | 6288384 | 0
2026-10-16T21:03:15.1948707+08:00 | 46 | OK | 2048 | 23 | 100.53316752 | 100.000 | 0.53316752 | 23052832.203125 | -16180 | 16100 | 6288384 | 0
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
