MasonHuang04/450SourceOri/02_RTL/V0/Simulation/Chirp/results/chirp_samples.csv

system_index | time_s | dac_code | ideal_code | error_code
0 | 0.000000000000 | 10240 | 10240 | 0
144 | 0.000000872727 | 10195 | 10195 | 0
288 | 0.000001745455 | 10064 | 10064 | 0
432 | 0.000002618182 | 9853 | 9853 | 0
576 | 0.000003490909 | 9569 | 9569 | 0
720 | 0.000004363636 | 9225 | 9225 | 0
864 | 0.000005236364 | 8837 | 8837 | 0
1008 | 0.000006109091 | 8421 | 8421 | 0
1152 | 0.000006981818 | 7995 | 7995 | 0
1296 | 0.000007854545 | 7578 | 7578 | 0
1440 | 0.000008727273 | 7187 | 7187 | 0
1584 | 0.000009600000 | 6840 | 6840 | 0
1728 | 0.000010472727 | 6551 | 6551 | 0
1872 | 0.000011345455 | 6333 | 6333 | 0
2016 | 0.000012218182 | 6196 | 6196 | 0
2160 | 0.000013090909 | 6145 | 6145 | 0
2304 | 0.000013963636 | 6182 | 6182 | 0
2448 | 0.000014836364 | 6307 | 6307 | 0
2592 | 0.000015709091 | 6513 | 6513 | 0
2736 | 0.000016581818 | 6792 | 6792 | 0
2880 | 0.000017454545 | 7131 | 7131 | 0
3024 | 0.000018327273 | 7516 | 7516 | 0
3168 | 0.000019200000 | 7931 | 7931 | 0
3312 | 0.000020072727 | 8357 | 8357 | 0
3456 | 0.000020945455 | 8775 | 8775 | 0
3600 | 0.000021818182 | 9169 | 9169 | 0
3744 | 0.000022690909 | 9520 | 9520 | 0
3888 | 0.000023563636 | 9814 | 9814 | 0
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
