MasonHuang04/450SourceOri/verification/AcousticAudit_20261020/data/20261020_165208_ed7a25_peaks.csv

time | source | sequence | status | peak_hz | target_hz | error_hz | power_code_squared | bin | fft_count | flags | raw_count | raw_dt_s | tx_center_hz | tx_bandwidth_hz | tx_duration_s | tx_amplitude | raw_bin_hz | delta_q16 | interpolation_status | interpolation_valid | fft_length | short_window_warning
2026-10-20T16:52:08.6610357+08:00 | 串口 | 1 | OK | 61.5446576072524 | 100 | -38.4553423927476 | 252.90625 | 2 | 672 | 0 | 5442 | 3.49090919E-06 | 40000 | 4000 | 0.02 | 0.25 | 69.936116536458329 | -15727 | 0 | True | 1024 | True
2026-10-20T16:52:27.3800086+08:00 | 串口 | 2 | OK | 55.364313690612711 | 100 | -44.635686309387289 | 922.0625 | 2 | 672 | 0 | 5442 | 3.49090919E-06 | 40000 | 4000 | 0.02 | 0.25 | 69.936116536458329 | -27310 | 0 | True | 1024 | True
2026-10-20T16:52:28.5957185+08:00 | 串口 | 3 | OK | 57.428696891292923 | 100 | -42.571303108707077 | 405.078125 | 2 | 672 | 0 | 5442 | 3.49090919E-06 | 40000 | 4000 | 0.02 | 0.25 | 69.936116536458329 | -23441 | 0 | True | 1024 | True
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
