MasonHuang04/450SourceOri/verification/AcousticAudit_20261020/data/20261020_170453_7fee98_peaks.csv

time | source | sequence | status | peak_hz | target_hz | error_hz | power_code_squared | bin | fft_count | flags | raw_count | raw_dt_s | tx_center_hz | tx_bandwidth_hz | tx_duration_s | tx_amplitude | raw_bin_hz | delta_q16 | interpolation_status | interpolation_valid | fft_length | short_window_warning
2026-10-20T17:04:53.8186305+08:00 | 串口 | 1 | ADC_CLIPPED | 174.84029134114581 | 100 | 74.840291341145814 | 6199895.703125 | 5 | 672 | 4 | 5442 | 3.49090919E-06 | 40000 | 4000 | 0.02 | 0.25 | 174.84029134114581 | 0 | 1 | False | 1024 | False
2026-10-20T17:04:55.4570013+08:00 | 串口 | 2 | ADC_CLIPPED | 174.84029134114581 | 100 | 74.840291341145814 | 6364930.625 | 5 | 672 | 4 | 5442 | 3.49090919E-06 | 40000 | 4000 | 0.02 | 0.25 | 174.84029134114581 | 0 | 1 | False | 1024 | False
2026-10-20T17:04:56.7176710+08:00 | 串口 | 3 | ADC_CLIPPED | 174.84029134114581 | 100 | 74.840291341145814 | 6236233.015625 | 5 | 672 | 4 | 5442 | 3.49090919E-06 | 40000 | 4000 | 0.02 | 0.25 | 174.84029134114581 | 0 | 1 | False | 1024 | False
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
