MasonHuang04/450SourceOri/verification/AcousticAudit_20261020/data/rtl_capture.csv

case | index | code
0 | 0 | -4891
0 | 1 | -4819
0 | 2 | -4748
0 | 3 | -4676
0 | 4 | -4605
0 | 5 | -4533
0 | 6 | -4462
0 | 7 | -4390
0 | 8 | -4319
0 | 9 | -4248
0 | 10 | -4177
0 | 11 | -4106
0 | 12 | -4035
0 | 13 | -3964
0 | 14 | -3893
0 | 15 | -3822
0 | 16 | -3752
0 | 17 | -3681
0 | 18 | -3611
0 | 19 | -3541
0 | 20 | -3471
0 | 21 | -3401
0 | 22 | -3331
0 | 23 | -3262
0 | 24 | -3193
0 | 25 | -3124
0 | 26 | -3055
0 | 27 | -2986
0 | 28 | -2918
0 | 29 | -2849
0 | 30 | -2781
0 | 31 | -2713
0 | 32 | -2646
0 | 33 | -2579
0 | 34 | -2511
0 | 35 | -2445
0 | 36 | -2378
0 | 37 | -2312
0 | 38 | -2246
0 | 39 | -2180
0 | 40 | -2115
0 | 41 | -2050
0 | 42 | -1985
0 | 43 | -1920
0 | 44 | -1856
0 | 45 | -1792
0 | 46 | -1729
0 | 47 | -1666
0 | 48 | -1603
0 | 49 | -1541
0 | 50 | -1478
0 | 51 | -1417
0 | 52 | -1355
0 | 53 | -1294
0 | 54 | -1234
0 | 55 | -1174
0 | 56 | -1114
0 | 57 | -1054
0 | 58 | -996
0 | 59 | -937
0 | 60 | -879
0 | 61 | -821
0 | 62 | -764
0 | 63 | -707
0 | 64 | -651
0 | 65 | -595
0 | 66 | -540
0 | 67 | -485
0 | 68 | -430
0 | 69 | -376
0 | 70 | -323
0 | 71 | -269
0 | 72 | -217
0 | 73 | -165
0 | 74 | -113
0 | 75 | -62
0 | 76 | -12
0 | 77 | 37
0 | 78 | 87
0 | 79 | 136
0 | 80 | 184
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
