MasonHuang04/450SourceOri/verification/FFT/results/capture.csv

case | index | code | decimator_index
0 | 0 | 1593 | 55
0 | 1 | 1507 | 56
0 | 2 | 1412 | 57
0 | 3 | 1310 | 58
0 | 4 | 1200 | 59
0 | 5 | 1082 | 60
0 | 6 | 957 | 61
0 | 7 | 824 | 62
0 | 8 | 685 | 63
0 | 9 | 538 | 64
0 | 10 | 384 | 65
0 | 11 | 224 | 66
0 | 12 | 58 | 67
0 | 13 | -114 | 68
0 | 14 | -293 | 69
0 | 15 | -478 | 70
0 | 16 | -668 | 71
0 | 17 | -864 | 72
0 | 18 | -1064 | 73
0 | 19 | -1270 | 74
0 | 20 | -1480 | 75
0 | 21 | -1694 | 76
0 | 22 | -1913 | 77
0 | 23 | -2135 | 78
0 | 24 | -2361 | 79
0 | 25 | -2590 | 80
0 | 26 | -2822 | 81
0 | 27 | -3057 | 82
0 | 28 | -3294 | 83
0 | 29 | -3533 | 84
0 | 30 | -3774 | 85
0 | 31 | -4017 | 86
0 | 32 | -4260 | 87
0 | 33 | -4505 | 88
0 | 34 | -4750 | 89
0 | 35 | -4996 | 90
0 | 36 | -5242 | 91
0 | 37 | -5487 | 92
0 | 38 | -5732 | 93
0 | 39 | -5975 | 94
0 | 40 | -6218 | 95
0 | 41 | -6459 | 96
0 | 42 | -6698 | 97
0 | 43 | -6935 | 98
0 | 44 | -7170 | 99
0 | 45 | -7402 | 100
0 | 46 | -7631 | 101
0 | 47 | -7857 | 102
0 | 48 | -8080 | 103
0 | 49 | -8298 | 104
0 | 50 | -8513 | 105
0 | 51 | -8723 | 106
0 | 52 | -8929 | 107
0 | 53 | -9130 | 108
0 | 54 | -9325 | 109
0 | 55 | -9516 | 110
0 | 56 | -9701 | 111
0 | 57 | -9880 | 112
0 | 58 | -10053 | 113
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
