MasonHuang04/450SourceOri/02_RTL/V0/Simulation/Chirp/results/chirp.png

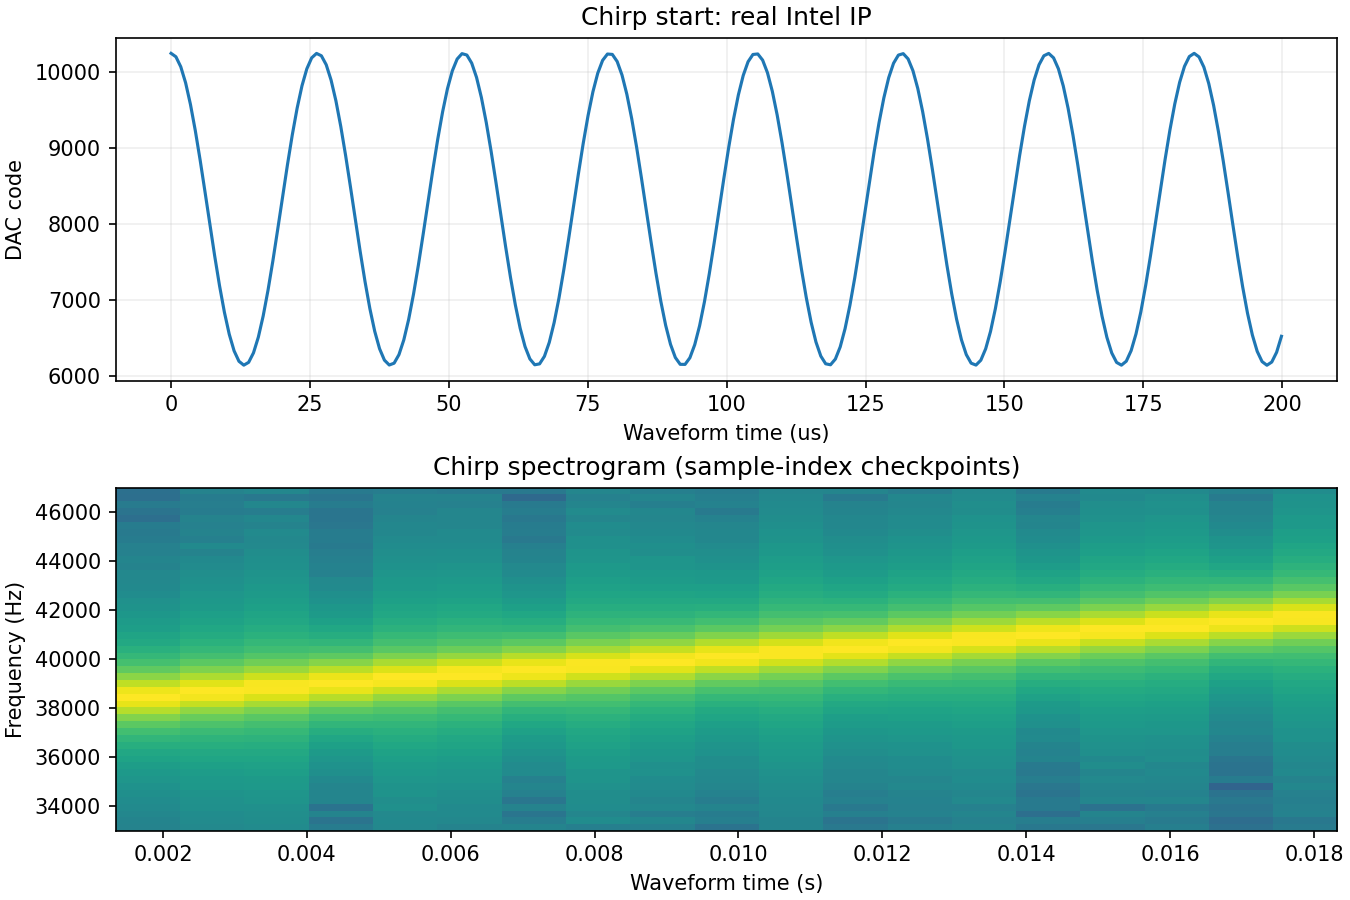
02_RTL/V0/Simulation/Chirp/results/chirp.png
