MasonHuang04/450SourceOri/02_RTL/V0/Simulation/FFT/results/fft.png

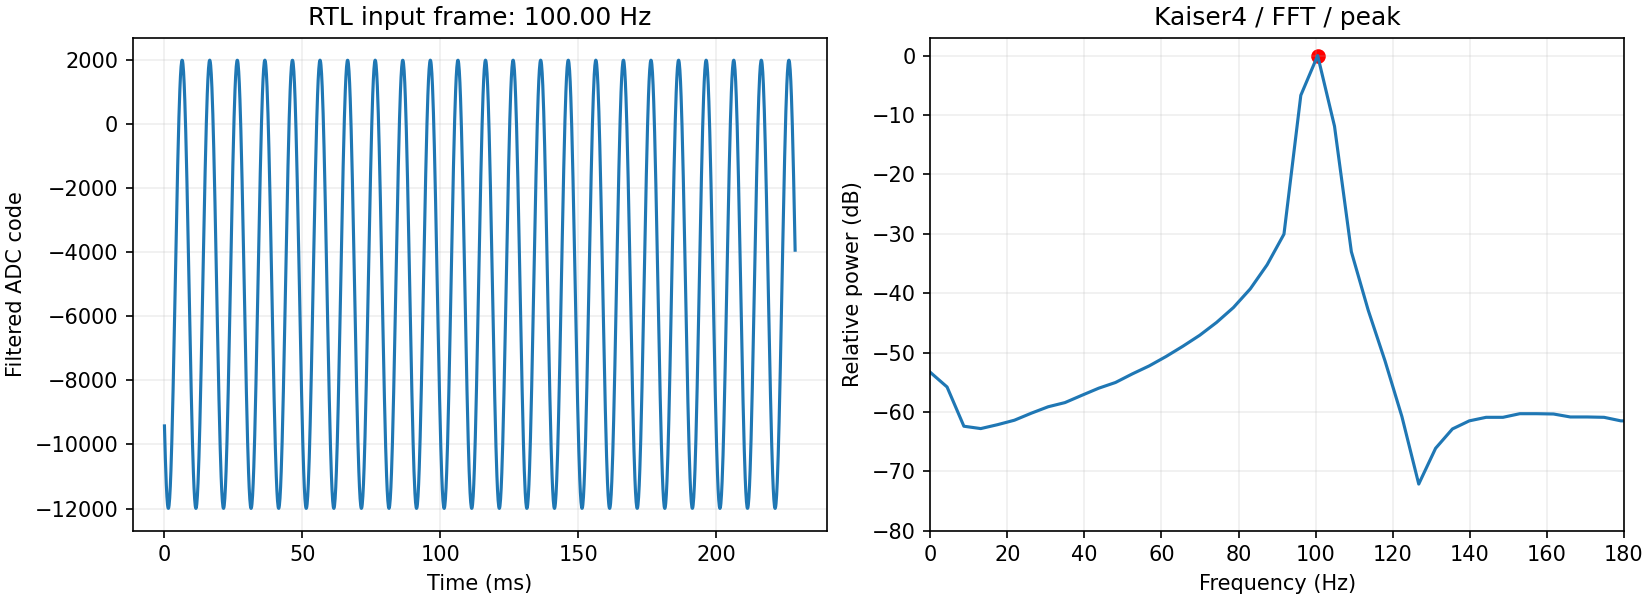
02_RTL/V0/Simulation/FFT/results/fft.png
