MasonHuang04/450SourceOri/verification/FFT/DistanceSweep_20261021/English/in_range_error_EN.png

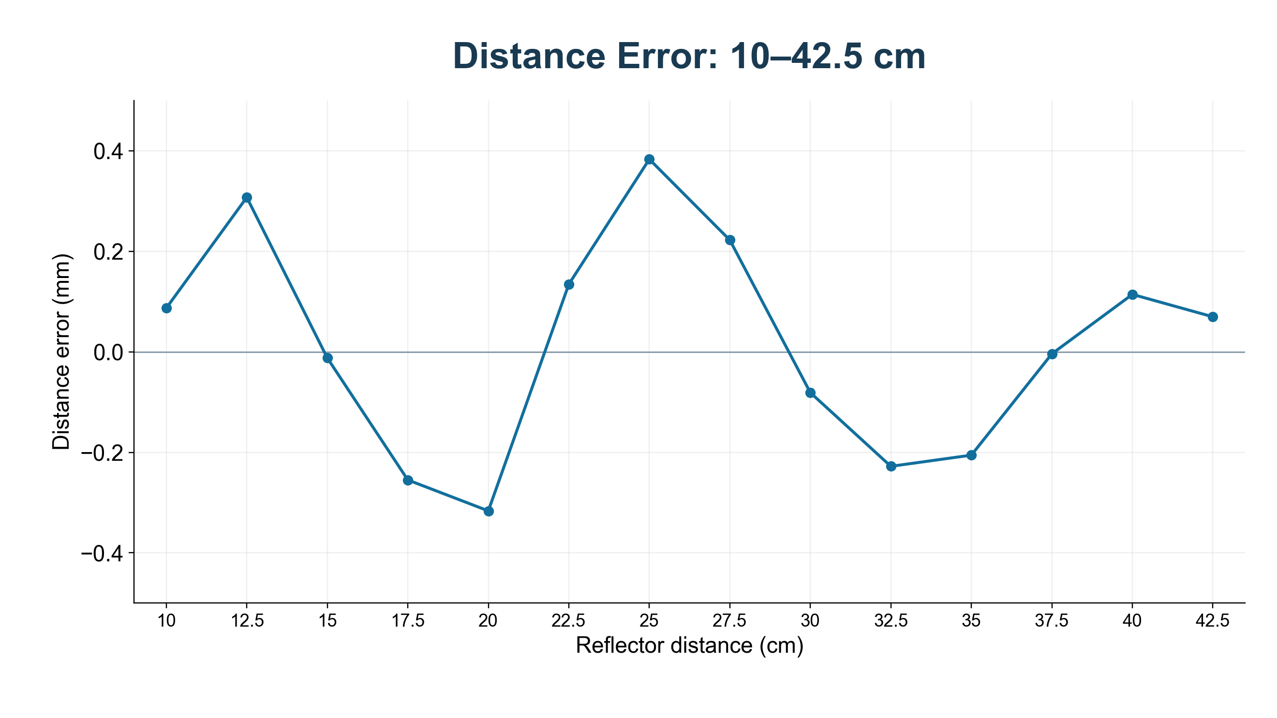
verification/FFT/DistanceSweep_20261021/English/in_range_error_EN.png
