MasonHuang04/450SourceOri/verification/FFT/TemperatureRange_20261021/ui_compact.png

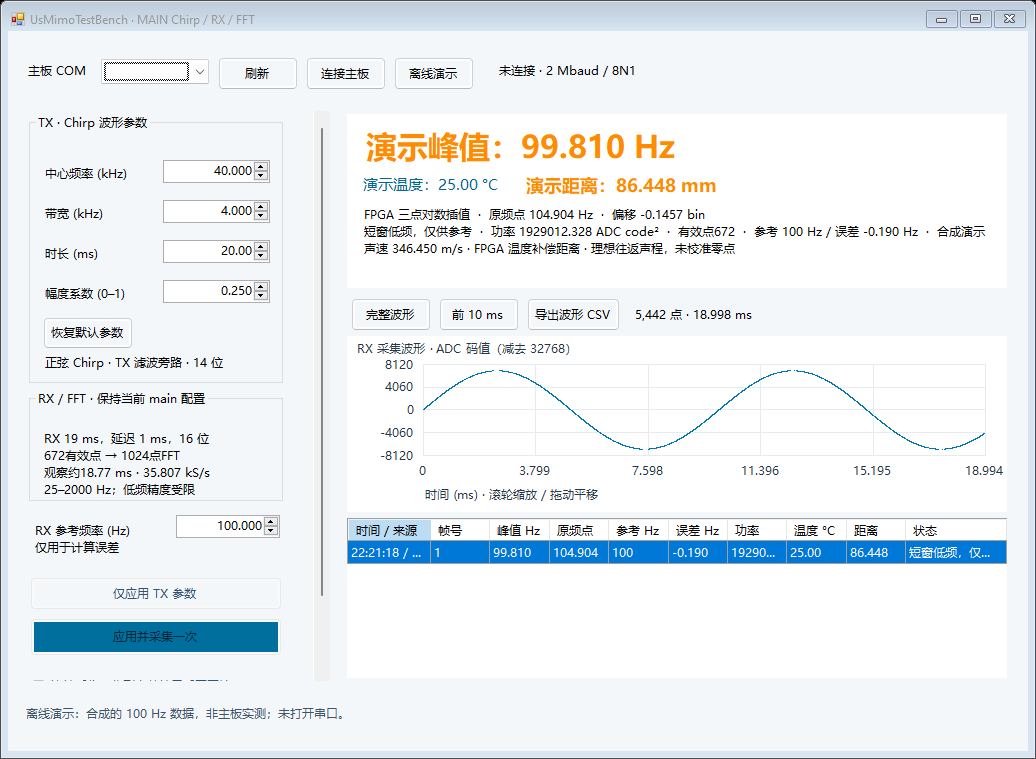
verification/FFT/TemperatureRange_20261021/ui_compact.png
