MasonHuang04/450SourceOri/verification/Figures/200k_summary/01_TX_sweep.png

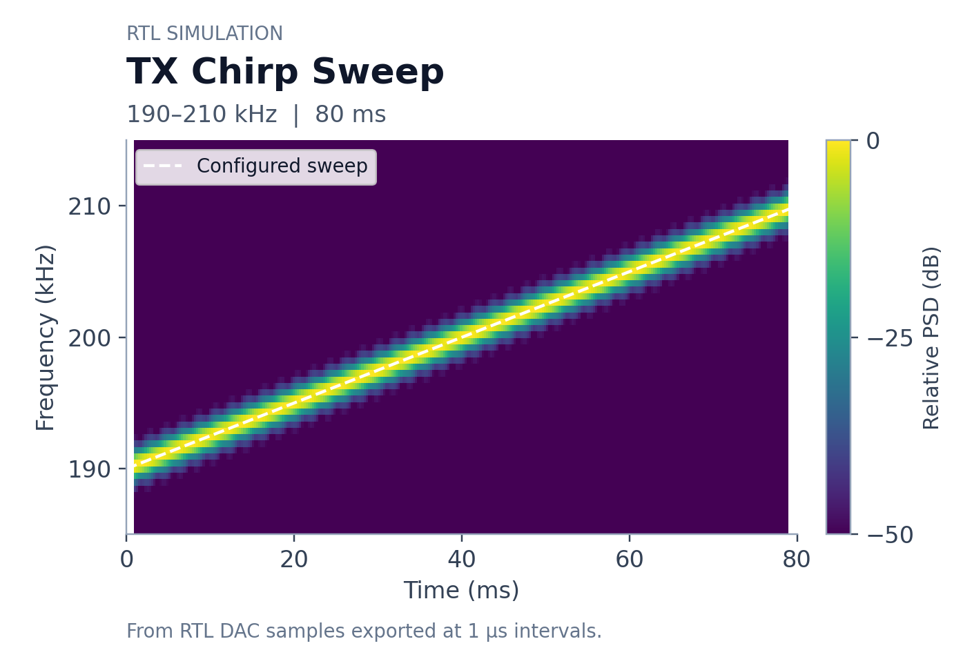
verification/Figures/200k_summary/01_TX_sweep.png
