MasonHuang04/450SourceOri/verification/Figures/200k_summary/02_RX_aligned.png

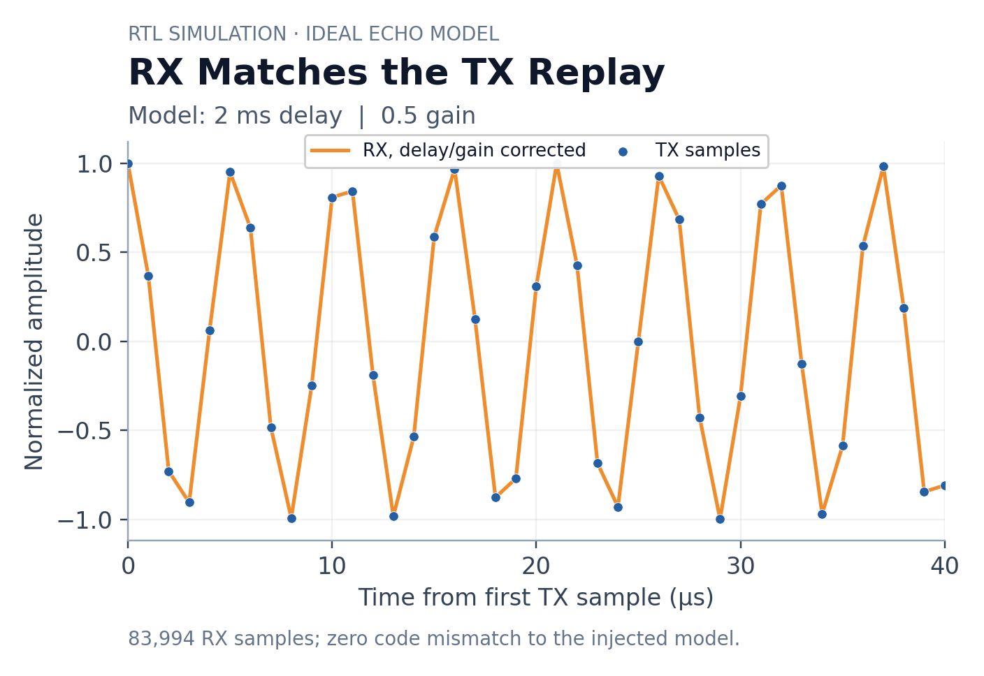
verification/Figures/200k_summary/02_RX_aligned.png
