MasonHuang04/450SourceOri/verification/Figures/fft_reference_input/FFT_Input_725p587Hz.png

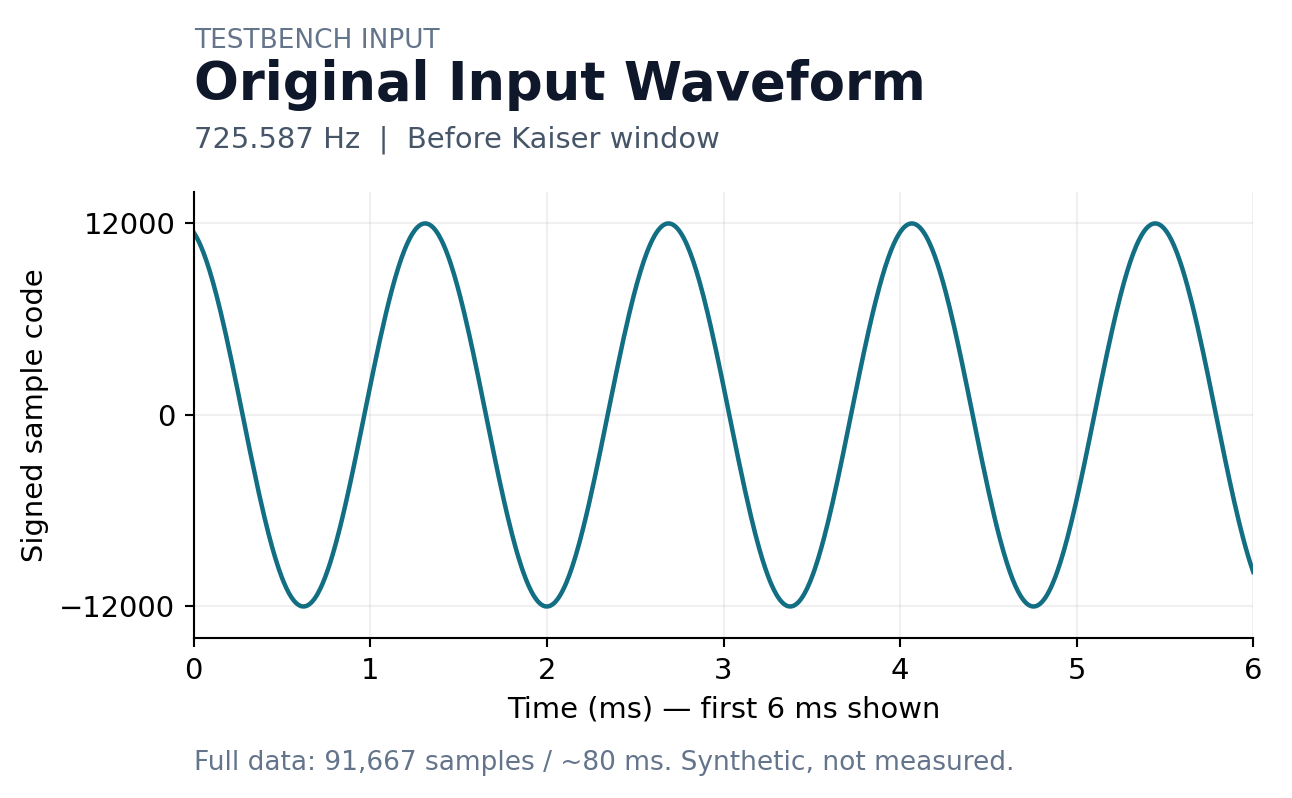
verification/Figures/fft_reference_input/FFT_Input_725p587Hz.png
