MasonHuang04/450SourceOri/verification/Measurements/evidence/experiment1_scope_41p95khz.jpg

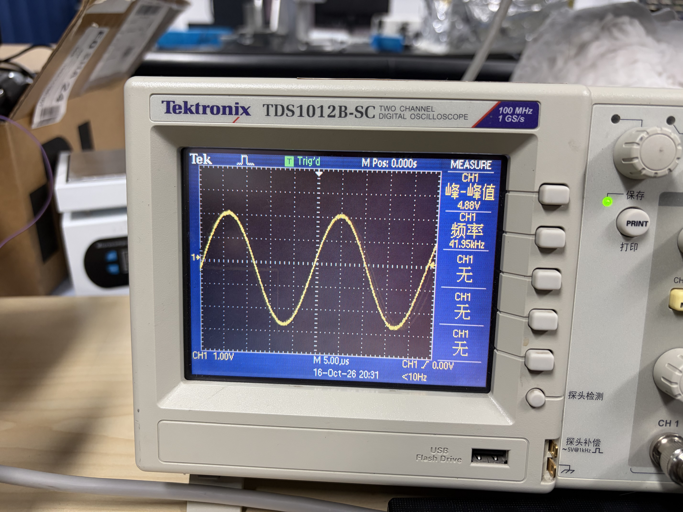
verification/Measurements/evidence/experiment1_scope_41p95khz.jpg
