MasonHuang04/450SourceOri/verification/SW/MainUI_20261017/ui_normal.png

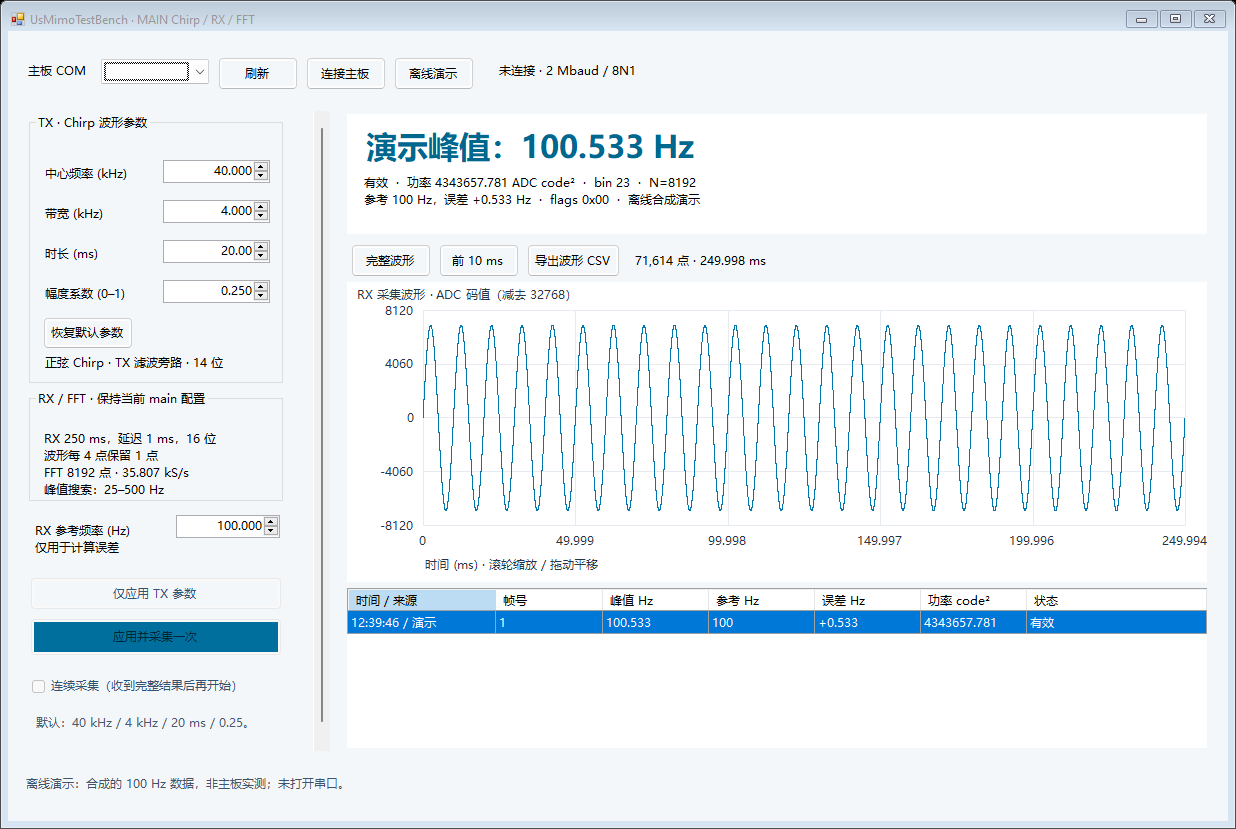
verification/SW/MainUI_20261017/ui_normal.png
