MasonHuang04/450SourceOri/WORKFLOW_Demo_FFT_Validation.png

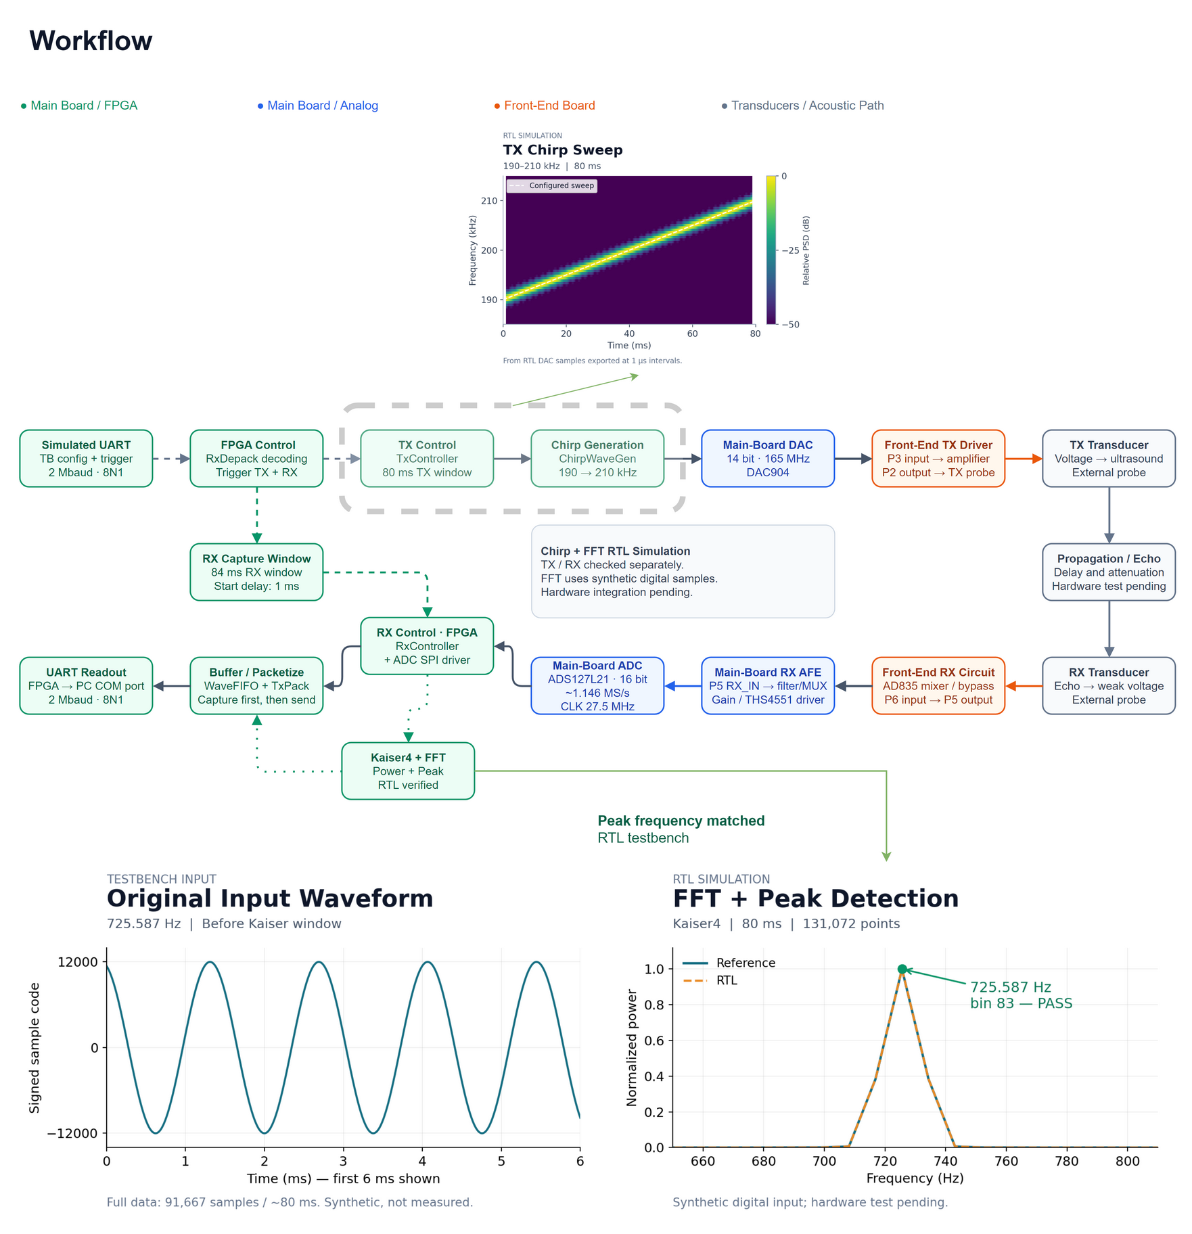
WORKFLOW_Demo_FFT_Validation.png
