MasonHuang04/450SourceOri/调试时的电路更改.txt

	1. TX的最后跟随器U13自激，810换320
	2. TX前端的U10放大器，放大倍率变成5.1倍，把R27换5.1K，R21换51K.
	3. TX前端的2个功放，变成2倍反向放大。1脚接R12V，前级接一个1K电阻到2脚，然后2脚接一个2.2NF到地。反馈电阻换成2K，并联200PF.
	4. RX的3296电阻接错，把其中2个脚并联。
	5. 乘法器会引入偏置，要考虑做偏置消除。
THS4551的输入侧电容，C205,C206.不接。可能是LAYOUT问题导致了振荡。
