MasonHuang04/450SourceOri/(list of files, drawings)

Other design files:
01_Elec/01_MainBoard/A0/01_Power.SchDoc
01_Elec/01_MainBoard/A0/02_Analog.SchDoc
01_Elec/01_MainBoard/A0/03_IO.SchDoc
01_Elec/01_MainBoard/A0/PS-25-001-E-01.PcbDoc
01_Elec/01_MainBoard/A0/UsMimoTestBench_MainBoard.PrjPcb
01_Elec/02_FrontEnd/PS-25-001-E-02.PcbDoc
01_Elec/02_FrontEnd/UsFrontEnd.SchDoc
01_Elec/02_FrontEnd/UsMimoTestBench_FrontEnd.PrjPcb
