MasonHuang04/450SourceOri/02_RTL/V0/SourceCode/DSP/FPFFP32ToInt32/FPFFP32ToInt32/FPFFP32ToInt32_0002.vhd

-- ------------------------------------------------------------------------- 
-- High Level Design Compiler for Intel(R) FPGAs Version 20.1 (Release Build #720)
-- Quartus Prime development tool and MATLAB/Simulink Interface
-- 
-- Legal Notice: Copyright 2020 Intel Corporation.  All rights reserved.
-- Your use of  Intel Corporation's design tools,  logic functions and other
-- software and  tools, and its AMPP partner logic functions, and any output
-- files any  of the foregoing (including  device programming  or simulation
-- files), and  any associated  documentation  or information  are expressly
-- subject  to the terms and  conditions of the  Intel FPGA Software License
-- Agreement, Intel MegaCore Function License Agreement, or other applicable
-- license agreement,  including,  without limitation,  that your use is for
-- the  sole  purpose of  programming  logic devices  manufactured by  Intel
-- and  sold by Intel  or its authorized  distributors. Please refer  to the
-- applicable agreement for further details.
-- ---------------------------------------------------------------------------

-- VHDL created from FPFFP32ToInt32_0002
-- VHDL created on Mon Mar 10 16:55:37 2025


library IEEE;
use IEEE.std_logic_1164.all;
use IEEE.NUMERIC_STD.all;
use IEEE.MATH_REAL.all;
use std.TextIO.all;
use work.dspba_library_package.all;

LIBRARY altera_mf;
USE altera_mf.altera_mf_components.all;
LIBRARY altera_lnsim;
USE altera_lnsim.altera_lnsim_components.altera_syncram;
LIBRARY lpm;
USE lpm.lpm_components.all;

entity FPFFP32ToInt32_0002 is
    port (
        a : in std_logic_vector(31 downto 0);  -- float32_m23
        q : out std_logic_vector(31 downto 0);  -- sfix32
        clk : in std_logic;
        areset : in std_logic
    );
end FPFFP32ToInt32_0002;

architecture normal of FPFFP32ToInt32_0002 is

    attribute altera_attribute : string;
    attribute altera_attribute of normal : architecture is "-name AUTO_SHIFT_REGISTER_RECOGNITION OFF; -name PHYSICAL_SYNTHESIS_REGISTER_DUPLICATION ON; -name MESSAGE_DISABLE 10036; -name MESSAGE_DISABLE 10037; -name MESSAGE_DISABLE 14130; -name MESSAGE_DISABLE 14320; -name MESSAGE_DISABLE 15400; -name MESSAGE_DISABLE 14130; -name MESSAGE_DISABLE 10036; -name MESSAGE_DISABLE 12020; -name MESSAGE_DISABLE 12030; -name MESSAGE_DISABLE 12010; -name MESSAGE_DISABLE 12110; -name MESSAGE_DISABLE 14320; -name MESSAGE_DISABLE 13410; -name MESSAGE_DISABLE 113007";
    
    signal GND_q : STD_LOGIC_VECTOR (0 downto 0);
    signal VCC_q : STD_LOGIC_VECTOR (0 downto 0);
    signal cstAllOWE_uid6_fpToFxPTest_q : STD_LOGIC_VECTOR (7 downto 0);
    signal cstZeroWF_uid7_fpToFxPTest_q : STD_LOGIC_VECTOR (22 downto 0);
    signal cstAllZWE_uid8_fpToFxPTest_q : STD_LOGIC_VECTOR (7 downto 0);
    signal exp_x_uid9_fpToFxPTest_b : STD_LOGIC_VECTOR (7 downto 0);
    signal frac_x_uid10_fpToFxPTest_b : STD_LOGIC_VECTOR (22 downto 0);
    signal excZ_x_uid11_fpToFxPTest_qi : STD_LOGIC_VECTOR (0 downto 0);
    signal excZ_x_uid11_fpToFxPTest_q : STD_LOGIC_VECTOR (0 downto 0);
    signal expXIsMax_uid12_fpToFxPTest_qi : STD_LOGIC_VECTOR (0 downto 0);
    signal expXIsMax_uid12_fpToFxPTest_q : STD_LOGIC_VECTOR (0 downto 0);
    signal fracXIsZero_uid13_fpToFxPTest_q : STD_LOGIC_VECTOR (0 downto 0);
    signal fracXIsNotZero_uid14_fpToFxPTest_q : STD_LOGIC_VECTOR (0 downto 0);
    signal excI_x_uid15_fpToFxPTest_qi : STD_LOGIC_VECTOR (0 downto 0);
    signal excI_x_uid15_fpToFxPTest_q : STD_LOGIC_VECTOR (0 downto 0);
    signal excN_x_uid16_fpToFxPTest_qi : STD_LOGIC_VECTOR (0 downto 0);
    signal excN_x_uid16_fpToFxPTest_q : STD_LOGIC_VECTOR (0 downto 0);
    signal invExcXZ_uid22_fpToFxPTest_q : STD_LOGIC_VECTOR (0 downto 0);
    signal oFracX_uid23_fpToFxPTest_q : STD_LOGIC_VECTOR (23 downto 0);
    signal signX_uid25_fpToFxPTest_b : STD_LOGIC_VECTOR (0 downto 0);
    signal ovfExpVal_uid26_fpToFxPTest_q : STD_LOGIC_VECTOR (8 downto 0);
    signal ovfExpRange_uid27_fpToFxPTest_a : STD_LOGIC_VECTOR (10 downto 0);
    signal ovfExpRange_uid27_fpToFxPTest_b : STD_LOGIC_VECTOR (10 downto 0);
    signal ovfExpRange_uid27_fpToFxPTest_o : STD_LOGIC_VECTOR (10 downto 0);
    signal ovfExpRange_uid27_fpToFxPTest_n : STD_LOGIC_VECTOR (0 downto 0);
    signal udfExpVal_uid28_fpToFxPTest_q : STD_LOGIC_VECTOR (7 downto 0);
    signal udf_uid29_fpToFxPTest_a : STD_LOGIC_VECTOR (10 downto 0);
    signal udf_uid29_fpToFxPTest_b : STD_LOGIC_VECTOR (10 downto 0);
    signal udf_uid29_fpToFxPTest_o : STD_LOGIC_VECTOR (10 downto 0);
    signal udf_uid29_fpToFxPTest_n : STD_LOGIC_VECTOR (0 downto 0);
    signal ovfExpVal_uid30_fpToFxPTest_q : STD_LOGIC_VECTOR (8 downto 0);
    signal shiftValE_uid31_fpToFxPTest_a : STD_LOGIC_VECTOR (10 downto 0);
    signal shiftValE_uid31_fpToFxPTest_b : STD_LOGIC_VECTOR (10 downto 0);
    signal shiftValE_uid31_fpToFxPTest_o : STD_LOGIC_VECTOR (10 downto 0);
    signal shiftValE_uid31_fpToFxPTest_q : STD_LOGIC_VECTOR (9 downto 0);
    signal shiftValRaw_uid32_fpToFxPTest_in : STD_LOGIC_VECTOR (5 downto 0);
    signal shiftValRaw_uid32_fpToFxPTest_b : STD_LOGIC_VECTOR (5 downto 0);
    signal maxShiftCst_uid33_fpToFxPTest_q : STD_LOGIC_VECTOR (5 downto 0);
    signal shiftOutOfRange_uid34_fpToFxPTest_a : STD_LOGIC_VECTOR (11 downto 0);
    signal shiftOutOfRange_uid34_fpToFxPTest_b : STD_LOGIC_VECTOR (11 downto 0);
    signal shiftOutOfRange_uid34_fpToFxPTest_o : STD_LOGIC_VECTOR (11 downto 0);
    signal shiftOutOfRange_uid34_fpToFxPTest_n : STD_LOGIC_VECTOR (0 downto 0);
    signal shiftVal_uid35_fpToFxPTest_s : STD_LOGIC_VECTOR (0 downto 0);
    signal shiftVal_uid35_fpToFxPTest_q : STD_LOGIC_VECTOR (5 downto 0);
    signal shifterIn_uid37_fpToFxPTest_q : STD_LOGIC_VECTOR (31 downto 0);
    signal maxPosValueS_uid39_fpToFxPTest_q : STD_LOGIC_VECTOR (31 downto 0);
    signal maxNegValueS_uid40_fpToFxPTest_q : STD_LOGIC_VECTOR (31 downto 0);
    signal zRightShiferNoStickyOut_uid41_fpToFxPTest_q : STD_LOGIC_VECTOR (32 downto 0);
    signal xXorSignE_uid42_fpToFxPTest_b : STD_LOGIC_VECTOR (32 downto 0);
    signal xXorSignE_uid42_fpToFxPTest_q : STD_LOGIC_VECTOR (32 downto 0);
    signal d0_uid43_fpToFxPTest_q : STD_LOGIC_VECTOR (2 downto 0);
    signal sPostRndFull_uid44_fpToFxPTest_a : STD_LOGIC_VECTOR (33 downto 0);
    signal sPostRndFull_uid44_fpToFxPTest_b : STD_LOGIC_VECTOR (33 downto 0);
    signal sPostRndFull_uid44_fpToFxPTest_o : STD_LOGIC_VECTOR (33 downto 0);
    signal sPostRndFull_uid44_fpToFxPTest_q : STD_LOGIC_VECTOR (33 downto 0);
    signal sPostRnd_uid45_fpToFxPTest_in : STD_LOGIC_VECTOR (32 downto 0);
    signal sPostRnd_uid45_fpToFxPTest_b : STD_LOGIC_VECTOR (31 downto 0);
    signal sPostRnd_uid46_fpToFxPTest_in : STD_LOGIC_VECTOR (34 downto 0);
    signal sPostRnd_uid46_fpToFxPTest_b : STD_LOGIC_VECTOR (33 downto 0);
    signal rndOvfPos_uid47_fpToFxPTest_a : STD_LOGIC_VECTOR (35 downto 0);
    signal rndOvfPos_uid47_fpToFxPTest_b : STD_LOGIC_VECTOR (35 downto 0);
    signal rndOvfPos_uid47_fpToFxPTest_o : STD_LOGIC_VECTOR (35 downto 0);
    signal rndOvfPos_uid47_fpToFxPTest_c : STD_LOGIC_VECTOR (0 downto 0);
    signal ovfPostRnd_uid48_fpToFxPTest_q : STD_LOGIC_VECTOR (0 downto 0);
    signal muxSelConc_uid49_fpToFxPTest_q : STD_LOGIC_VECTOR (2 downto 0);
    signal muxSel_uid50_fpToFxPTest_q : STD_LOGIC_VECTOR (1 downto 0);
    signal maxNegValueU_uid51_fpToFxPTest_q : STD_LOGIC_VECTOR (31 downto 0);
    signal finalOut_uid52_fpToFxPTest_s : STD_LOGIC_VECTOR (1 downto 0);
    signal finalOut_uid52_fpToFxPTest_q : STD_LOGIC_VECTOR (31 downto 0);
    signal rightShiftStage0Idx1Rng16_uid56_rightShiferNoStickyOut_uid38_fpToFxPTest_b : STD_LOGIC_VECTOR (15 downto 0);
    signal rightShiftStage0Idx1Pad16_uid57_rightShiferNoStickyOut_uid38_fpToFxPTest_q : STD_LOGIC_VECTOR (15 downto 0);
    signal rightShiftStage0Idx1_uid58_rightShiferNoStickyOut_uid38_fpToFxPTest_q : STD_LOGIC_VECTOR (31 downto 0);
    signal rightShiftStage0_uid62_rightShiferNoStickyOut_uid38_fpToFxPTest_s : STD_LOGIC_VECTOR (1 downto 0);
    signal rightShiftStage0_uid62_rightShiferNoStickyOut_uid38_fpToFxPTest_q : STD_LOGIC_VECTOR (31 downto 0);
    signal rightShiftStage1Idx1Rng4_uid63_rightShiferNoStickyOut_uid38_fpToFxPTest_b : STD_LOGIC_VECTOR (27 downto 0);
    signal rightShiftStage1Idx1Pad4_uid64_rightShiferNoStickyOut_uid38_fpToFxPTest_q : STD_LOGIC_VECTOR (3 downto 0);
    signal rightShiftStage1Idx1_uid65_rightShiferNoStickyOut_uid38_fpToFxPTest_q : STD_LOGIC_VECTOR (31 downto 0);
    signal rightShiftStage1Idx2Rng8_uid66_rightShiferNoStickyOut_uid38_fpToFxPTest_b : STD_LOGIC_VECTOR (23 downto 0);
    signal rightShiftStage1Idx2_uid68_rightShiferNoStickyOut_uid38_fpToFxPTest_q : STD_LOGIC_VECTOR (31 downto 0);
    signal rightShiftStage1Idx3Rng12_uid69_rightShiferNoStickyOut_uid38_fpToFxPTest_b : STD_LOGIC_VECTOR (19 downto 0);
    signal rightShiftStage1Idx3Pad12_uid70_rightShiferNoStickyOut_uid38_fpToFxPTest_q : STD_LOGIC_VECTOR (11 downto 0);
    signal rightShiftStage1Idx3_uid71_rightShiferNoStickyOut_uid38_fpToFxPTest_q : STD_LOGIC_VECTOR (31 downto 0);
    signal rightShiftStage1_uid73_rightShiferNoStickyOut_uid38_fpToFxPTest_s : STD_LOGIC_VECTOR (1 downto 0);
    signal rightShiftStage1_uid73_rightShiferNoStickyOut_uid38_fpToFxPTest_q : STD_LOGIC_VECTOR (31 downto 0);
    signal rightShiftStage2Idx1Rng1_uid74_rightShiferNoStickyOut_uid38_fpToFxPTest_b : STD_LOGIC_VECTOR (30 downto 0);
    signal rightShiftStage2Idx1_uid76_rightShiferNoStickyOut_uid38_fpToFxPTest_q : STD_LOGIC_VECTOR (31 downto 0);
    signal rightShiftStage2Idx2Rng2_uid77_rightShiferNoStickyOut_uid38_fpToFxPTest_b : STD_LOGIC_VECTOR (29 downto 0);
    signal rightShiftStage2Idx2Pad2_uid78_rightShiferNoStickyOut_uid38_fpToFxPTest_q : STD_LOGIC_VECTOR (1 downto 0);
    signal rightShiftStage2Idx2_uid79_rightShiferNoStickyOut_uid38_fpToFxPTest_q : STD_LOGIC_VECTOR (31 downto 0);
    signal rightShiftStage2Idx3Rng3_uid80_rightShiferNoStickyOut_uid38_fpToFxPTest_b : STD_LOGIC_VECTOR (28 downto 0);
    signal rightShiftStage2Idx3Pad3_uid81_rightShiferNoStickyOut_uid38_fpToFxPTest_q : STD_LOGIC_VECTOR (2 downto 0);
    signal rightShiftStage2Idx3_uid82_rightShiferNoStickyOut_uid38_fpToFxPTest_q : STD_LOGIC_VECTOR (31 downto 0);
    signal rightShiftStage2_uid84_rightShiferNoStickyOut_uid38_fpToFxPTest_s : STD_LOGIC_VECTOR (1 downto 0);
    signal rightShiftStage2_uid84_rightShiferNoStickyOut_uid38_fpToFxPTest_q : STD_LOGIC_VECTOR (31 downto 0);
    signal rightShiftStageSel5Dto4_uid61_rightShiferNoStickyOut_uid38_fpToFxPTest_merged_bit_select_b : STD_LOGIC_VECTOR (1 downto 0);
    signal rightShiftStageSel5Dto4_uid61_rightShiferNoStickyOut_uid38_fpToFxPTest_merged_bit_select_c : STD_LOGIC_VECTOR (1 downto 0);
    signal rightShiftStageSel5Dto4_uid61_rightShiferNoStickyOut_uid38_fpToFxPTest_merged_bit_select_d : STD_LOGIC_VECTOR (1 downto 0);
    signal redist0_sPostRnd_uid45_fpToFxPTest_b_1_q : STD_LOGIC_VECTOR (31 downto 0);
    signal redist1_udf_uid29_fpToFxPTest_n_5_q : STD_LOGIC_VECTOR (0 downto 0);
    signal redist2_ovfExpRange_uid27_fpToFxPTest_n_5_q : STD_LOGIC_VECTOR (0 downto 0);
    signal redist3_signX_uid25_fpToFxPTest_b_3_q : STD_LOGIC_VECTOR (0 downto 0);
    signal redist4_signX_uid25_fpToFxPTest_b_5_q : STD_LOGIC_VECTOR (0 downto 0);
    signal redist5_excN_x_uid16_fpToFxPTest_q_3_q : STD_LOGIC_VECTOR (0 downto 0);
    signal redist6_excI_x_uid15_fpToFxPTest_q_3_q : STD_LOGIC_VECTOR (0 downto 0);
    signal redist7_expXIsMax_uid12_fpToFxPTest_q_2_q : STD_LOGIC_VECTOR (0 downto 0);
    signal redist8_excZ_x_uid11_fpToFxPTest_q_2_q : STD_LOGIC_VECTOR (0 downto 0);
    signal redist9_frac_x_uid10_fpToFxPTest_b_2_q : STD_LOGIC_VECTOR (22 downto 0);

begin


    -- maxNegValueU_uid51_fpToFxPTest(CONSTANT,50)
    maxNegValueU_uid51_fpToFxPTest_q <= "00000000000000000000000000000000";

    -- maxNegValueS_uid40_fpToFxPTest(CONSTANT,39)
    maxNegValueS_uid40_fpToFxPTest_q <= "10000000000000000000000000000000";

    -- maxPosValueS_uid39_fpToFxPTest(CONSTANT,38)
    maxPosValueS_uid39_fpToFxPTest_q <= "01111111111111111111111111111111";

    -- d0_uid43_fpToFxPTest(CONSTANT,42)
    d0_uid43_fpToFxPTest_q <= "001";

    -- signX_uid25_fpToFxPTest(BITSELECT,24)@0
    signX_uid25_fpToFxPTest_b <= STD_LOGIC_VECTOR(a(31 downto 31));

    -- redist3_signX_uid25_fpToFxPTest_b_3(DELAY,89)
    redist3_signX_uid25_fpToFxPTest_b_3 : dspba_delay
    GENERIC MAP ( width => 1, depth => 3, reset_kind => "ASYNC" )
    PORT MAP ( xin => signX_uid25_fpToFxPTest_b, xout => redist3_signX_uid25_fpToFxPTest_b_3_q, clk => clk, aclr => areset );

    -- GND(CONSTANT,0)
    GND_q <= "0";

    -- rightShiftStage2Idx3Pad3_uid81_rightShiferNoStickyOut_uid38_fpToFxPTest(CONSTANT,80)
    rightShiftStage2Idx3Pad3_uid81_rightShiferNoStickyOut_uid38_fpToFxPTest_q <= "000";

    -- rightShiftStage2Idx3Rng3_uid80_rightShiferNoStickyOut_uid38_fpToFxPTest(BITSELECT,79)@2
    rightShiftStage2Idx3Rng3_uid80_rightShiferNoStickyOut_uid38_fpToFxPTest_b <= rightShiftStage1_uid73_rightShiferNoStickyOut_uid38_fpToFxPTest_q(31 downto 3);

    -- rightShiftStage2Idx3_uid82_rightShiferNoStickyOut_uid38_fpToFxPTest(BITJOIN,81)@2
    rightShiftStage2Idx3_uid82_rightShiferNoStickyOut_uid38_fpToFxPTest_q <= rightShiftStage2Idx3Pad3_uid81_rightShiferNoStickyOut_uid38_fpToFxPTest_q & rightShiftStage2Idx3Rng3_uid80_rightShiferNoStickyOut_uid38_fpToFxPTest_b;

    -- rightShiftStage2Idx2Pad2_uid78_rightShiferNoStickyOut_uid38_fpToFxPTest(CONSTANT,77)
    rightShiftStage2Idx2Pad2_uid78_rightShiferNoStickyOut_uid38_fpToFxPTest_q <= "00";

    -- rightShiftStage2Idx2Rng2_uid77_rightShiferNoStickyOut_uid38_fpToFxPTest(BITSELECT,76)@2
    rightShiftStage2Idx2Rng2_uid77_rightShiferNoStickyOut_uid38_fpToFxPTest_b <= rightShiftStage1_uid73_rightShiferNoStickyOut_uid38_fpToFxPTest_q(31 downto 2);

    -- rightShiftStage2Idx2_uid79_rightShiferNoStickyOut_uid38_fpToFxPTest(BITJOIN,78)@2
    rightShiftStage2Idx2_uid79_rightShiferNoStickyOut_uid38_fpToFxPTest_q <= rightShiftStage2Idx2Pad2_uid78_rightShiferNoStickyOut_uid38_fpToFxPTest_q & rightShiftStage2Idx2Rng2_uid77_rightShiferNoStickyOut_uid38_fpToFxPTest_b;

    -- rightShiftStage2Idx1Rng1_uid74_rightShiferNoStickyOut_uid38_fpToFxPTest(BITSELECT,73)@2
    rightShiftStage2Idx1Rng1_uid74_rightShiferNoStickyOut_uid38_fpToFxPTest_b <= rightShiftStage1_uid73_rightShiferNoStickyOut_uid38_fpToFxPTest_q(31 downto 1);

    -- rightShiftStage2Idx1_uid76_rightShiferNoStickyOut_uid38_fpToFxPTest(BITJOIN,75)@2
    rightShiftStage2Idx1_uid76_rightShiferNoStickyOut_uid38_fpToFxPTest_q <= GND_q & rightShiftStage2Idx1Rng1_uid74_rightShiferNoStickyOut_uid38_fpToFxPTest_b;

    -- rightShiftStage1Idx3Pad12_uid70_rightShiferNoStickyOut_uid38_fpToFxPTest(CONSTANT,69)
    rightShiftStage1Idx3Pad12_uid70_rightShiferNoStickyOut_uid38_fpToFxPTest_q <= "000000000000";

    -- rightShiftStage1Idx3Rng12_uid69_rightShiferNoStickyOut_uid38_fpToFxPTest(BITSELECT,68)@2
    rightShiftStage1Idx3Rng12_uid69_rightShiferNoStickyOut_uid38_fpToFxPTest_b <= rightShiftStage0_uid62_rightShiferNoStickyOut_uid38_fpToFxPTest_q(31 downto 12);

    -- rightShiftStage1Idx3_uid71_rightShiferNoStickyOut_uid38_fpToFxPTest(BITJOIN,70)@2
    rightShiftStage1Idx3_uid71_rightShiferNoStickyOut_uid38_fpToFxPTest_q <= rightShiftStage1Idx3Pad12_uid70_rightShiferNoStickyOut_uid38_fpToFxPTest_q & rightShiftStage1Idx3Rng12_uid69_rightShiferNoStickyOut_uid38_fpToFxPTest_b;

    -- cstAllZWE_uid8_fpToFxPTest(CONSTANT,7)
    cstAllZWE_uid8_fpToFxPTest_q <= "00000000";

    -- rightShiftStage1Idx2Rng8_uid66_rightShiferNoStickyOut_uid38_fpToFxPTest(BITSELECT,65)@2
    rightShiftStage1Idx2Rng8_uid66_rightShiferNoStickyOut_uid38_fpToFxPTest_b <= rightShiftStage0_uid62_rightShiferNoStickyOut_uid38_fpToFxPTest_q(31 downto 8);

    -- rightShiftStage1Idx2_uid68_rightShiferNoStickyOut_uid38_fpToFxPTest(BITJOIN,67)@2
    rightShiftStage1Idx2_uid68_rightShiferNoStickyOut_uid38_fpToFxPTest_q <= cstAllZWE_uid8_fpToFxPTest_q & rightShiftStage1Idx2Rng8_uid66_rightShiferNoStickyOut_uid38_fpToFxPTest_b;

    -- rightShiftStage1Idx1Pad4_uid64_rightShiferNoStickyOut_uid38_fpToFxPTest(CONSTANT,63)
    rightShiftStage1Idx1Pad4_uid64_rightShiferNoStickyOut_uid38_fpToFxPTest_q <= "0000";

    -- rightShiftStage1Idx1Rng4_uid63_rightShiferNoStickyOut_uid38_fpToFxPTest(BITSELECT,62)@2
    rightShiftStage1Idx1Rng4_uid63_rightShiferNoStickyOut_uid38_fpToFxPTest_b <= rightShiftStage0_uid62_rightShiferNoStickyOut_uid38_fpToFxPTest_q(31 downto 4);

    -- rightShiftStage1Idx1_uid65_rightShiferNoStickyOut_uid38_fpToFxPTest(BITJOIN,64)@2
    rightShiftStage1Idx1_uid65_rightShiferNoStickyOut_uid38_fpToFxPTest_q <= rightShiftStage1Idx1Pad4_uid64_rightShiferNoStickyOut_uid38_fpToFxPTest_q & rightShiftStage1Idx1Rng4_uid63_rightShiferNoStickyOut_uid38_fpToFxPTest_b;

    -- rightShiftStage0Idx1Pad16_uid57_rightShiferNoStickyOut_uid38_fpToFxPTest(CONSTANT,56)
    rightShiftStage0Idx1Pad16_uid57_rightShiferNoStickyOut_uid38_fpToFxPTest_q <= "0000000000000000";

    -- rightShiftStage0Idx1Rng16_uid56_rightShiferNoStickyOut_uid38_fpToFxPTest(BITSELECT,55)@2
    rightShiftStage0Idx1Rng16_uid56_rightShiferNoStickyOut_uid38_fpToFxPTest_b <= shifterIn_uid37_fpToFxPTest_q(31 downto 16);

    -- rightShiftStage0Idx1_uid58_rightShiferNoStickyOut_uid38_fpToFxPTest(BITJOIN,57)@2
    rightShiftStage0Idx1_uid58_rightShiferNoStickyOut_uid38_fpToFxPTest_q <= rightShiftStage0Idx1Pad16_uid57_rightShiferNoStickyOut_uid38_fpToFxPTest_q & rightShiftStage0Idx1Rng16_uid56_rightShiferNoStickyOut_uid38_fpToFxPTest_b;

    -- exp_x_uid9_fpToFxPTest(BITSELECT,8)@0
    exp_x_uid9_fpToFxPTest_b <= a(30 downto 23);

    -- excZ_x_uid11_fpToFxPTest(LOGICAL,10)@0 + 1
    excZ_x_uid11_fpToFxPTest_qi <= "1" WHEN exp_x_uid9_fpToFxPTest_b = cstAllZWE_uid8_fpToFxPTest_q ELSE "0";
    excZ_x_uid11_fpToFxPTest_delay : dspba_delay
    GENERIC MAP ( width => 1, depth => 1, reset_kind => "ASYNC" )
    PORT MAP ( xin => excZ_x_uid11_fpToFxPTest_qi, xout => excZ_x_uid11_fpToFxPTest_q, clk => clk, aclr => areset );

    -- redist8_excZ_x_uid11_fpToFxPTest_q_2(DELAY,94)
    redist8_excZ_x_uid11_fpToFxPTest_q_2 : dspba_delay
    GENERIC MAP ( width => 1, depth => 1, reset_kind => "ASYNC" )
    PORT MAP ( xin => excZ_x_uid11_fpToFxPTest_q, xout => redist8_excZ_x_uid11_fpToFxPTest_q_2_q, clk => clk, aclr => areset );

    -- invExcXZ_uid22_fpToFxPTest(LOGICAL,21)@2
    invExcXZ_uid22_fpToFxPTest_q <= not (redist8_excZ_x_uid11_fpToFxPTest_q_2_q);

    -- frac_x_uid10_fpToFxPTest(BITSELECT,9)@0
    frac_x_uid10_fpToFxPTest_b <= a(22 downto 0);

    -- redist9_frac_x_uid10_fpToFxPTest_b_2(DELAY,95)
    redist9_frac_x_uid10_fpToFxPTest_b_2 : dspba_delay
    GENERIC MAP ( width => 23, depth => 2, reset_kind => "ASYNC" )
    PORT MAP ( xin => frac_x_uid10_fpToFxPTest_b, xout => redist9_frac_x_uid10_fpToFxPTest_b_2_q, clk => clk, aclr => areset );

    -- oFracX_uid23_fpToFxPTest(BITJOIN,22)@2
    oFracX_uid23_fpToFxPTest_q <= invExcXZ_uid22_fpToFxPTest_q & redist9_frac_x_uid10_fpToFxPTest_b_2_q;

    -- shifterIn_uid37_fpToFxPTest(BITJOIN,36)@2
    shifterIn_uid37_fpToFxPTest_q <= oFracX_uid23_fpToFxPTest_q & cstAllZWE_uid8_fpToFxPTest_q;

    -- rightShiftStage0_uid62_rightShiferNoStickyOut_uid38_fpToFxPTest(MUX,61)@2
    rightShiftStage0_uid62_rightShiferNoStickyOut_uid38_fpToFxPTest_s <= rightShiftStageSel5Dto4_uid61_rightShiferNoStickyOut_uid38_fpToFxPTest_merged_bit_select_b;
    rightShiftStage0_uid62_rightShiferNoStickyOut_uid38_fpToFxPTest_combproc: PROCESS (rightShiftStage0_uid62_rightShiferNoStickyOut_uid38_fpToFxPTest_s, shifterIn_uid37_fpToFxPTest_q, rightShiftStage0Idx1_uid58_rightShiferNoStickyOut_uid38_fpToFxPTest_q, maxNegValueU_uid51_fpToFxPTest_q)
    BEGIN
        CASE (rightShiftStage0_uid62_rightShiferNoStickyOut_uid38_fpToFxPTest_s) IS
            WHEN "00" => rightShiftStage0_uid62_rightShiferNoStickyOut_uid38_fpToFxPTest_q <= shifterIn_uid37_fpToFxPTest_q;
            WHEN "01" => rightShiftStage0_uid62_rightShiferNoStickyOut_uid38_fpToFxPTest_q <= rightShiftStage0Idx1_uid58_rightShiferNoStickyOut_uid38_fpToFxPTest_q;
            WHEN "10" => rightShiftStage0_uid62_rightShiferNoStickyOut_uid38_fpToFxPTest_q <= maxNegValueU_uid51_fpToFxPTest_q;
            WHEN "11" => rightShiftStage0_uid62_rightShiferNoStickyOut_uid38_fpToFxPTest_q <= maxNegValueU_uid51_fpToFxPTest_q;
            WHEN OTHERS => rightShiftStage0_uid62_rightShiferNoStickyOut_uid38_fpToFxPTest_q <= (others => '0');
        END CASE;
    END PROCESS;

    -- rightShiftStage1_uid73_rightShiferNoStickyOut_uid38_fpToFxPTest(MUX,72)@2
    rightShiftStage1_uid73_rightShiferNoStickyOut_uid38_fpToFxPTest_s <= rightShiftStageSel5Dto4_uid61_rightShiferNoStickyOut_uid38_fpToFxPTest_merged_bit_select_c;
    rightShiftStage1_uid73_rightShiferNoStickyOut_uid38_fpToFxPTest_combproc: PROCESS (rightShiftStage1_uid73_rightShiferNoStickyOut_uid38_fpToFxPTest_s, rightShiftStage0_uid62_rightShiferNoStickyOut_uid38_fpToFxPTest_q, rightShiftStage1Idx1_uid65_rightShiferNoStickyOut_uid38_fpToFxPTest_q, rightShiftStage1Idx2_uid68_rightShiferNoStickyOut_uid38_fpToFxPTest_q, rightShiftStage1Idx3_uid71_rightShiferNoStickyOut_uid38_fpToFxPTest_q)
    BEGIN
        CASE (rightShiftStage1_uid73_rightShiferNoStickyOut_uid38_fpToFxPTest_s) IS
            WHEN "00" => rightShiftStage1_uid73_rightShiferNoStickyOut_uid38_fpToFxPTest_q <= rightShiftStage0_uid62_rightShiferNoStickyOut_uid38_fpToFxPTest_q;
            WHEN "01" => rightShiftStage1_uid73_rightShiferNoStickyOut_uid38_fpToFxPTest_q <= rightShiftStage1Idx1_uid65_rightShiferNoStickyOut_uid38_fpToFxPTest_q;
            WHEN "10" => rightShiftStage1_uid73_rightShiferNoStickyOut_uid38_fpToFxPTest_q <= rightShiftStage1Idx2_uid68_rightShiferNoStickyOut_uid38_fpToFxPTest_q;
            WHEN "11" => rightShiftStage1_uid73_rightShiferNoStickyOut_uid38_fpToFxPTest_q <= rightShiftStage1Idx3_uid71_rightShiferNoStickyOut_uid38_fpToFxPTest_q;
            WHEN OTHERS => rightShiftStage1_uid73_rightShiferNoStickyOut_uid38_fpToFxPTest_q <= (others => '0');
        END CASE;
    END PROCESS;

    -- maxShiftCst_uid33_fpToFxPTest(CONSTANT,32)
    maxShiftCst_uid33_fpToFxPTest_q <= "100000";

    -- ovfExpVal_uid30_fpToFxPTest(CONSTANT,29)
    ovfExpVal_uid30_fpToFxPTest_q <= "010011101";

    -- shiftValE_uid31_fpToFxPTest(SUB,30)@0 + 1
    shiftValE_uid31_fpToFxPTest_a <= STD_LOGIC_VECTOR(STD_LOGIC_VECTOR((10 downto 9 => ovfExpVal_uid30_fpToFxPTest_q(8)) & ovfExpVal_uid30_fpToFxPTest_q));
    shiftValE_uid31_fpToFxPTest_b <= STD_LOGIC_VECTOR(STD_LOGIC_VECTOR("000" & exp_x_uid9_fpToFxPTest_b));
    shiftValE_uid31_fpToFxPTest_clkproc: PROCESS (clk, areset)
    BEGIN
        IF (areset = '1') THEN
            shiftValE_uid31_fpToFxPTest_o <= (others => '0');
        ELSIF (clk'EVENT AND clk = '1') THEN
            shiftValE_uid31_fpToFxPTest_o <= STD_LOGIC_VECTOR(SIGNED(shiftValE_uid31_fpToFxPTest_a) - SIGNED(shiftValE_uid31_fpToFxPTest_b));
        END IF;
    END PROCESS;
    shiftValE_uid31_fpToFxPTest_q <= shiftValE_uid31_fpToFxPTest_o(9 downto 0);

    -- shiftValRaw_uid32_fpToFxPTest(BITSELECT,31)@1
    shiftValRaw_uid32_fpToFxPTest_in <= shiftValE_uid31_fpToFxPTest_q(5 downto 0);
    shiftValRaw_uid32_fpToFxPTest_b <= shiftValRaw_uid32_fpToFxPTest_in(5 downto 0);

    -- shiftOutOfRange_uid34_fpToFxPTest(COMPARE,33)@1
    shiftOutOfRange_uid34_fpToFxPTest_a <= STD_LOGIC_VECTOR(STD_LOGIC_VECTOR((11 downto 10 => shiftValE_uid31_fpToFxPTest_q(9)) & shiftValE_uid31_fpToFxPTest_q));
    shiftOutOfRange_uid34_fpToFxPTest_b <= STD_LOGIC_VECTOR(STD_LOGIC_VECTOR("000000" & maxShiftCst_uid33_fpToFxPTest_q));
    shiftOutOfRange_uid34_fpToFxPTest_o <= STD_LOGIC_VECTOR(SIGNED(shiftOutOfRange_uid34_fpToFxPTest_a) - SIGNED(shiftOutOfRange_uid34_fpToFxPTest_b));
    shiftOutOfRange_uid34_fpToFxPTest_n(0) <= not (shiftOutOfRange_uid34_fpToFxPTest_o(11));

    -- shiftVal_uid35_fpToFxPTest(MUX,34)@1 + 1
    shiftVal_uid35_fpToFxPTest_s <= shiftOutOfRange_uid34_fpToFxPTest_n;
    shiftVal_uid35_fpToFxPTest_clkproc: PROCESS (clk, areset)
    BEGIN
        IF (areset = '1') THEN
            shiftVal_uid35_fpToFxPTest_q <= (others => '0');
        ELSIF (clk'EVENT AND clk = '1') THEN
            CASE (shiftVal_uid35_fpToFxPTest_s) IS
                WHEN "0" => shiftVal_uid35_fpToFxPTest_q <= shiftValRaw_uid32_fpToFxPTest_b;
                WHEN "1" => shiftVal_uid35_fpToFxPTest_q <= maxShiftCst_uid33_fpToFxPTest_q;
                WHEN OTHERS => shiftVal_uid35_fpToFxPTest_q <= (others => '0');
            END CASE;
        END IF;
    END PROCESS;

    -- rightShiftStageSel5Dto4_uid61_rightShiferNoStickyOut_uid38_fpToFxPTest_merged_bit_select(BITSELECT,85)@2
    rightShiftStageSel5Dto4_uid61_rightShiferNoStickyOut_uid38_fpToFxPTest_merged_bit_select_b <= shiftVal_uid35_fpToFxPTest_q(5 downto 4);
    rightShiftStageSel5Dto4_uid61_rightShiferNoStickyOut_uid38_fpToFxPTest_merged_bit_select_c <= shiftVal_uid35_fpToFxPTest_q(3 downto 2);
    rightShiftStageSel5Dto4_uid61_rightShiferNoStickyOut_uid38_fpToFxPTest_merged_bit_select_d <= shiftVal_uid35_fpToFxPTest_q(1 downto 0);

    -- rightShiftStage2_uid84_rightShiferNoStickyOut_uid38_fpToFxPTest(MUX,83)@2 + 1
    rightShiftStage2_uid84_rightShiferNoStickyOut_uid38_fpToFxPTest_s <= rightShiftStageSel5Dto4_uid61_rightShiferNoStickyOut_uid38_fpToFxPTest_merged_bit_select_d;
    rightShiftStage2_uid84_rightShiferNoStickyOut_uid38_fpToFxPTest_clkproc: PROCESS (clk, areset)
    BEGIN
        IF (areset = '1') THEN
            rightShiftStage2_uid84_rightShiferNoStickyOut_uid38_fpToFxPTest_q <= (others => '0');
        ELSIF (clk'EVENT AND clk = '1') THEN
            CASE (rightShiftStage2_uid84_rightShiferNoStickyOut_uid38_fpToFxPTest_s) IS
                WHEN "00" => rightShiftStage2_uid84_rightShiferNoStickyOut_uid38_fpToFxPTest_q <= rightShiftStage1_uid73_rightShiferNoStickyOut_uid38_fpToFxPTest_q;
                WHEN "01" => rightShiftStage2_uid84_rightShiferNoStickyOut_uid38_fpToFxPTest_q <= rightShiftStage2Idx1_uid76_rightShiferNoStickyOut_uid38_fpToFxPTest_q;
                WHEN "10" => rightShiftStage2_uid84_rightShiferNoStickyOut_uid38_fpToFxPTest_q <= rightShiftStage2Idx2_uid79_rightShiferNoStickyOut_uid38_fpToFxPTest_q;
                WHEN "11" => rightShiftStage2_uid84_rightShiferNoStickyOut_uid38_fpToFxPTest_q <= rightShiftStage2Idx3_uid82_rightShiferNoStickyOut_uid38_fpToFxPTest_q;
                WHEN OTHERS => rightShiftStage2_uid84_rightShiferNoStickyOut_uid38_fpToFxPTest_q <= (others => '0');
            END CASE;
        END IF;
    END PROCESS;
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
