MasonHuang04/450SourceOri/(commit log)

2026-10-17 Import current ultrasonic FPGA and desktop workflow
    [01_Power.SchDoc, 02_Analog.SchDoc, 03_IO.SchDoc, AD.stp, FFT_20261016_203942.csv, FFT_20261016_204036.csv, FFT_20261016_204215.csv, FFT_20261016_204247.csv]
2026-10-20 Add overall workflow
    [comparison.csv, main_comparison.csv]
2026-10-20 Audit acoustic peak switching and preserve dated verification evidence
    [20261020_165208_ed7a25_peaks.csv, 20261020_170453_7fee98_peaks.csv, envelope_model.csv, ideal_beats.csv, measured_jumps.csv, rtl_capture.csv, rtl_metadata.csv, rtl_spectrum.csv]
2026-10-28 Save analog-mixer Main ranging workflow and verification
    Preserve the 25-2000 Hz search, FPGA temperature-compensated range, desktop updates, MATLAB studies and measurement diagnostics. Document the analog RX input and independent main branch workflow. Keep matched programming files and exclude local rollback copies.
    Validation: exported staged-project desktop self-test passed; Main SOF/EXE hashes match the saved build record. Functional source and deployable bytes preserved during repository setup.
    [assumed_resonator_results.csv, comparison.csv, cpu_scenarios.csv, distance_results.csv, example_75cm_rf_samples.csv, example_75cm_selected_samples.csv, fpga_entities.csv, memory_budget.csv]
2026-11-01 Document analog mixer workflow and verify the released Main build
    Record the analog IF routing, frame-based FFT processing, and remaining hardware calibration limits. Verify 150 source files against the baseline build and TemperatureRange release manifest, the current SOF/GUI hashes, and the archived 84 timing checks. Rerun the desktop protocol self-test.
    Keep functional RTL, SOF and application bytes unchanged. Preserve the distinction between old analog-mixer near-range anomalies and new raw-RX clipping measurements.
    [export_check.csv]
